RileyMcCarthy/IO_Board/Hardware/Tensile_Board.jpg

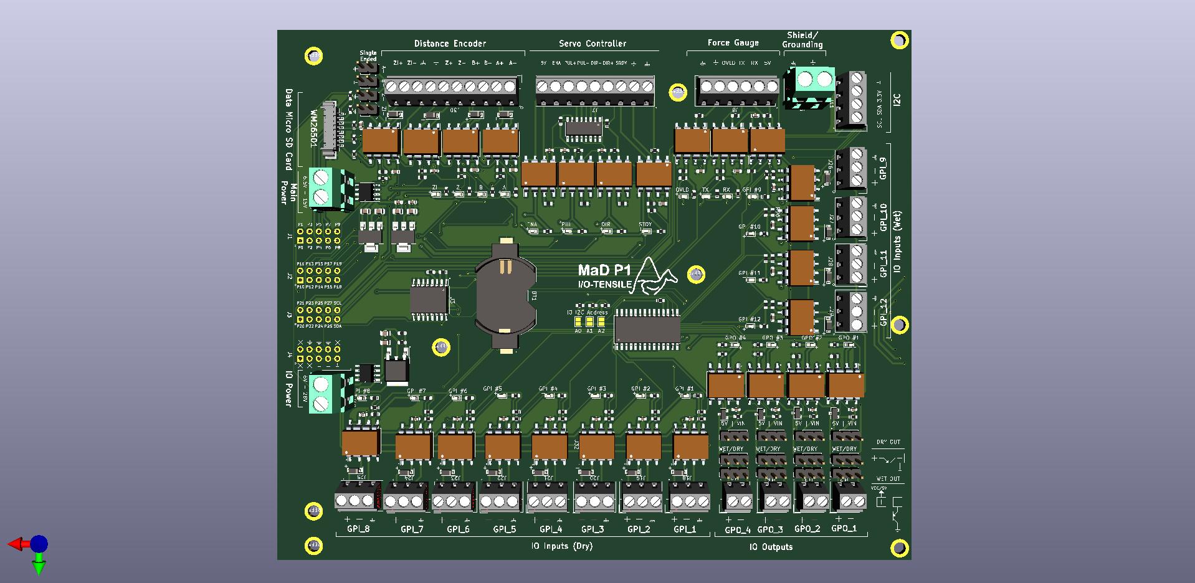
Hardware/Tensile_Board.jpg
