RileyMcCarthy/IO_Board/Docs/3D Views/Tensile_Board_Top.png

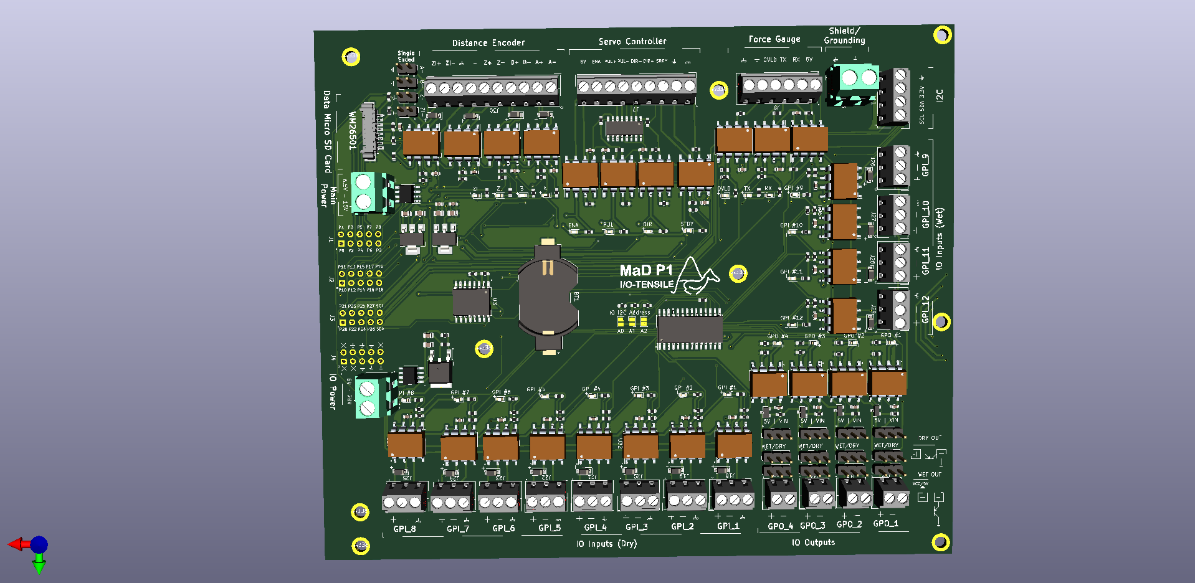
Docs/3D Views/Tensile_Board_Top.png
