RileyMcCarthy/IO_Board/README.md

# IO Board

The IO board is an extension for the Mad Board to maintain an isolated connection to the tensile testing machine.
