RileyMcCarthy/IO_Board/Docs/3D Views/Tensile_Board_Bottom.png

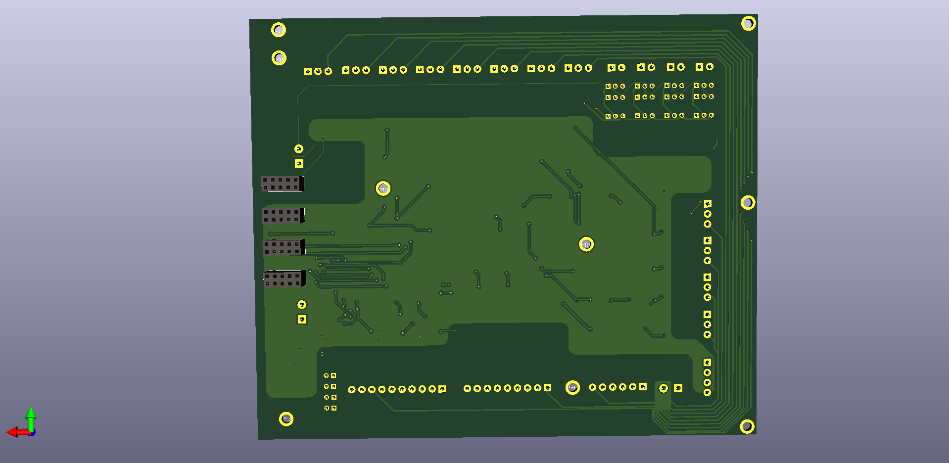
Docs/3D Views/Tensile_Board_Bottom.png
