RileyMcCarthy/IO_Board/Hardware/IO.xlsx

IO | USE | Type | Section | Notes
P0 | SCL2 | OUT | GPIO,RTC
P1 | SCK | OUT | Display Touch
P2 | MOSI | OUT | Display Touch
P3 | MISO | IN | Display Touch
P4 | SD2_DAT3 | IN/OUT | SD Card Data
P5 | SD2_CLK | OUT | SD Card Data
P6 | SD2_CMD | OUT | SD Card Data
P7 | SD2_DAT0 | IN/OUT | SD Card Data | Replaced display touch interrupt
P8 | Backlight | OUT | Display | Backlight replaced with OUTZI
P9 | Reset | OUT | Display
P10 | Chip Select | OUT | Display
P11 | ENA | OUT | Servo Controller
P12 | DIR | OUT | Servo Controller
P13 | PUL | OUT | Servo Controller
P14 | SRDY | IN | Servo Controller
P15 | Force TX | IN | Force Gauge
P16 | Force RX | OUT | Force Gauge
P17 | Overload | IN | Force Gauge
P18 | Status LED | OUT/IN | Charge Pump
P19 | OUTA | IN | Distance A
P20 | OUTB | IN | Distance B
P21 | OUTZ | IN | Distance Z
P22 | SD1_DAT0 | IN/OUT | SD Card Program
P23 | SD1_CLK | OUT | SD Card Program
P24 | SD1_CMD | OUT | SD Card Program
P25 | SD1_DAT3 | IN/OUT | SD Card Program
P26 | SDA2 | OUT/IN | GPIO,RTC
SCL | Peripheral I2C Clock | OUT | Display touch, navkey,eeprom
SDA | Peripheral I2C Data | IN/OUT | Display touch, navkey,eeprom
TX | transmitting | OUT | USB
RX | receiving | IN | USB
