RileyMcCarthy/IO_Board/CAD/Spacer.STEP

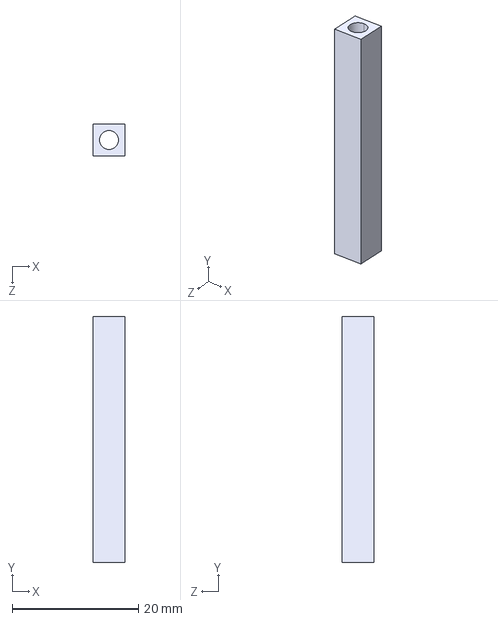
[picture p4: CAD file, 2021-04-02]
CAD/Spacer.STEP
5.00 x 39.0 x 5.00 mm
