RileyMcCarthy/IO_Board/(list of files, cad)

Other CAD files:
CAD/Spacer.SLDPRT
CAD/Spacer.STL
