RileyMcCarthy/IO_Board/Docs/Schematics/Tensile_Board.pdf

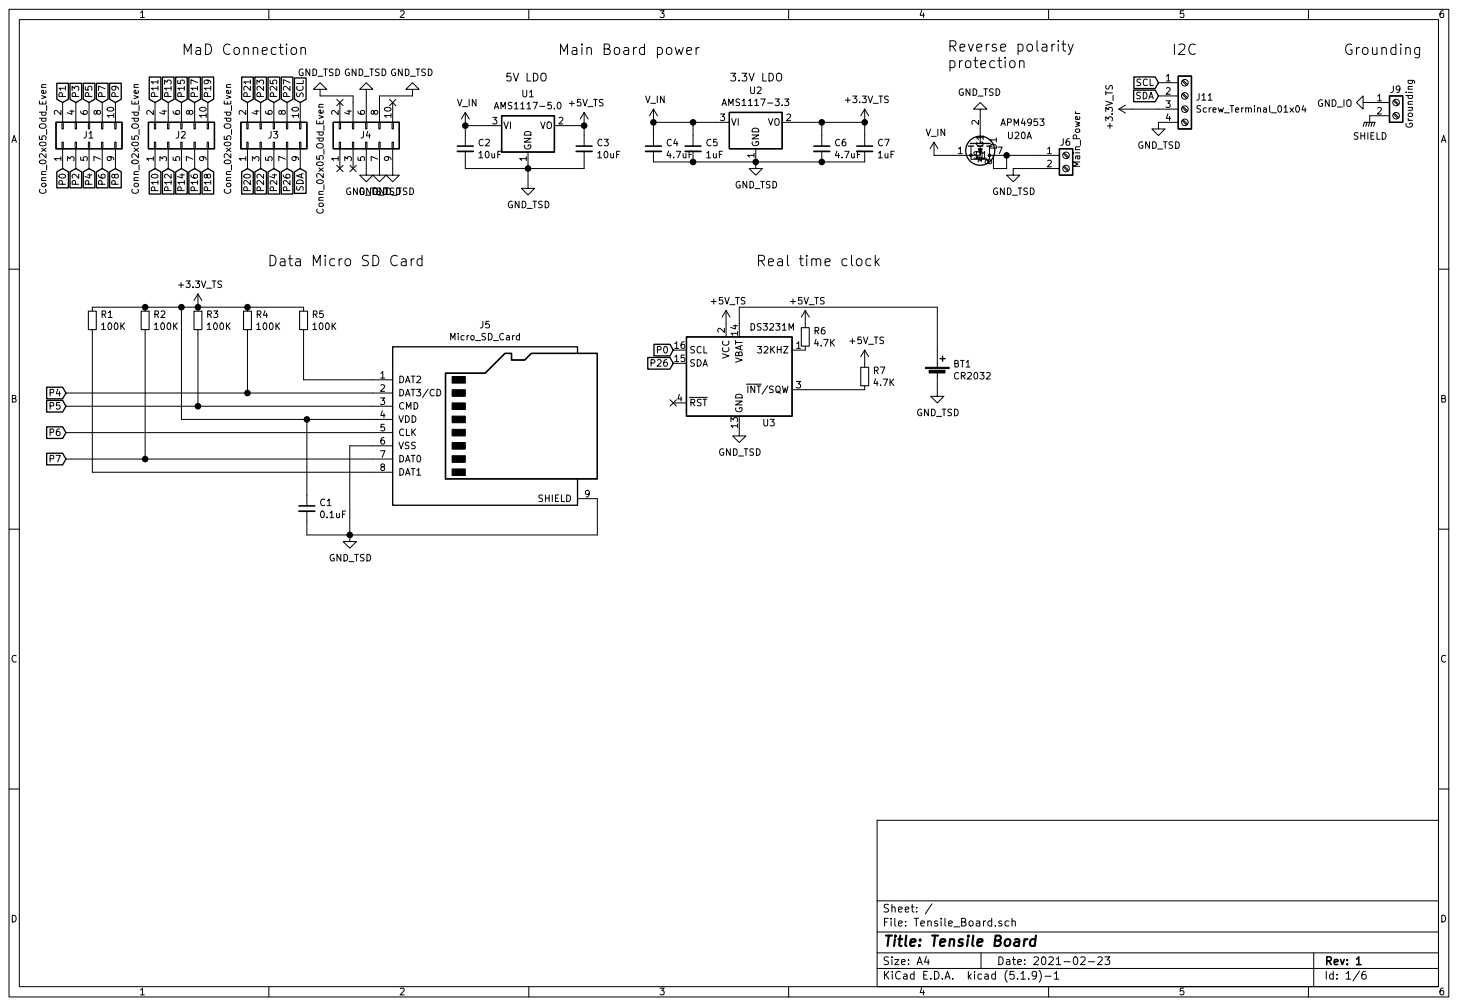
[picture p5: page 1]

File: Tensile_Board.sch Sheet: / Sheet: Force_Gauge

Id: 1/6 Title: Tensile Board

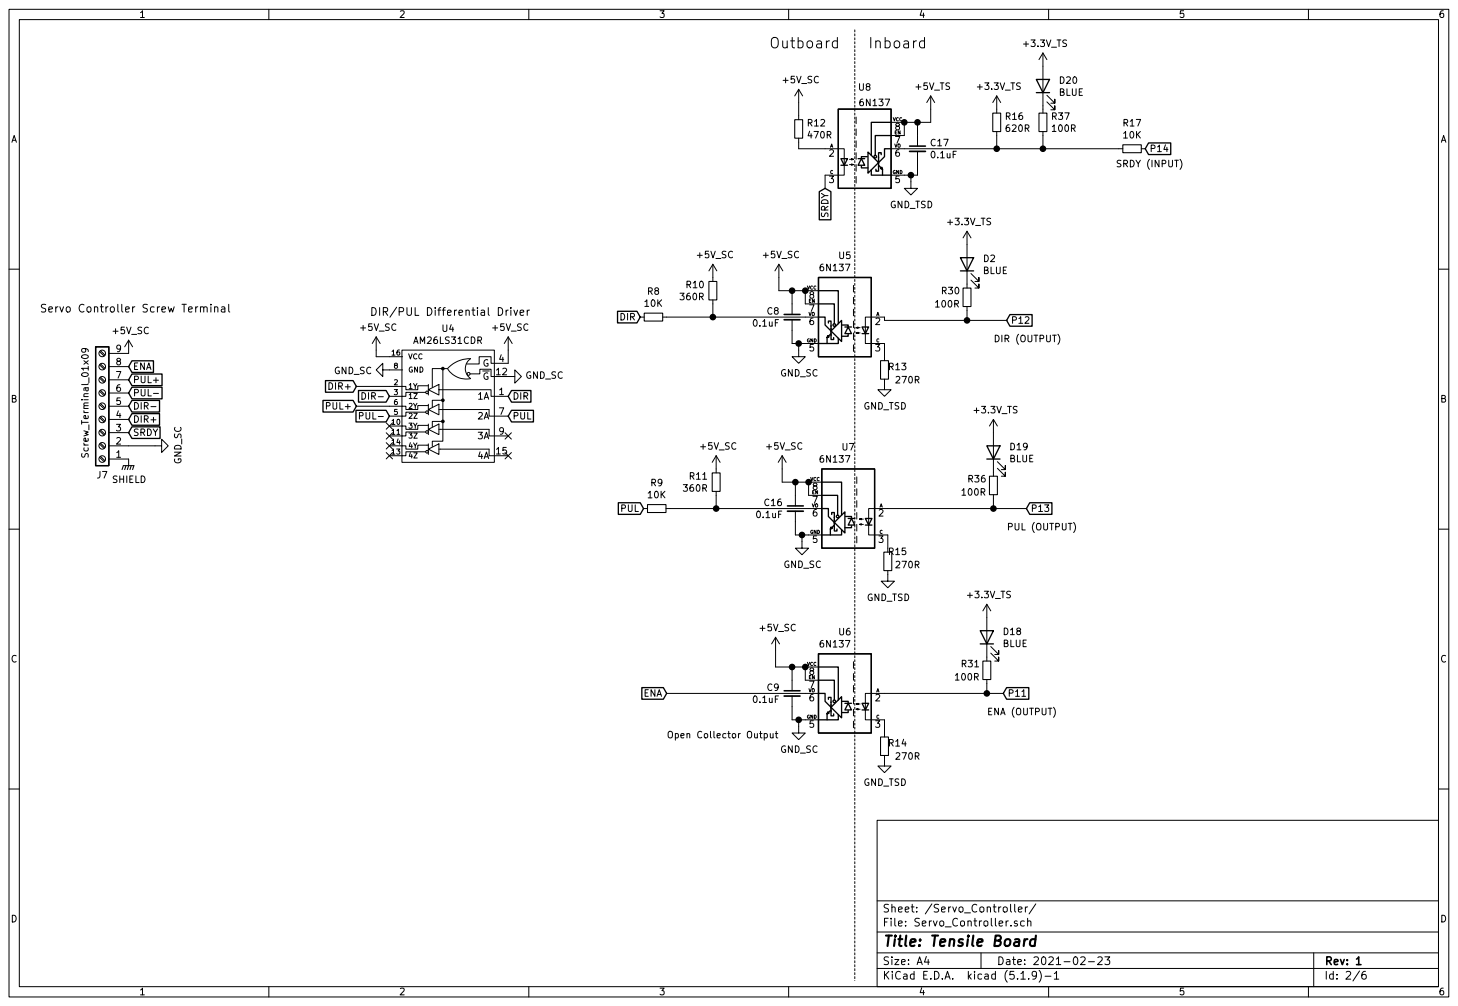
[picture p6: page 2]

Sheet: /Servo_Controller/
File: Servo_Controller.sch
Id: 2/6 Title: Tensile Board

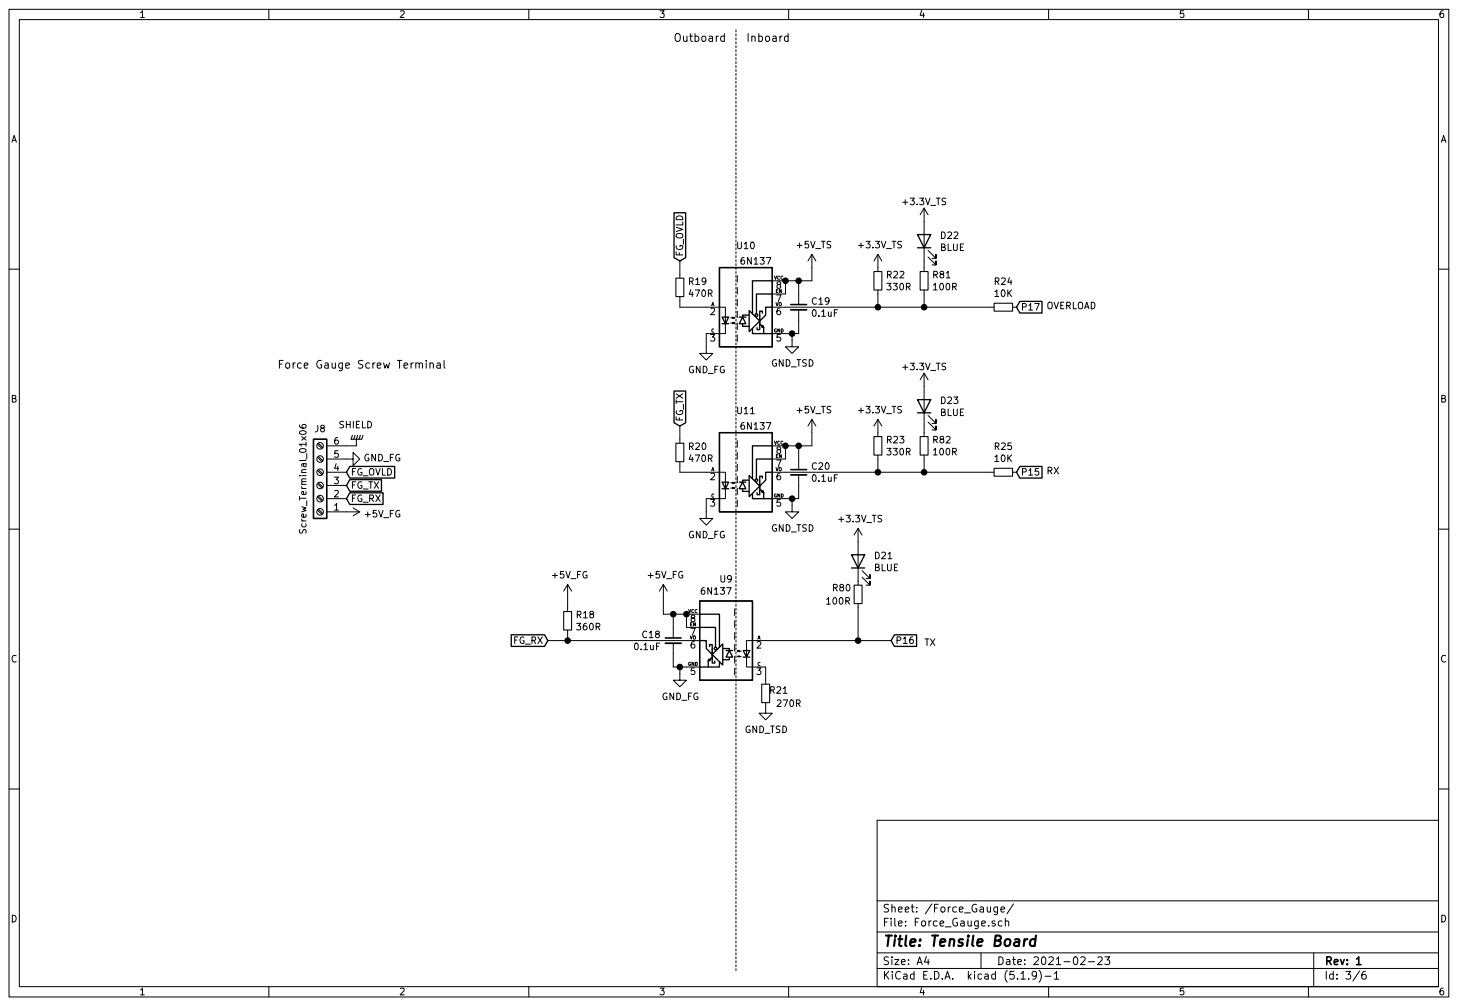
[picture p7: page 3]

File: Force_Gauge.sch
Id: 3/6 Title: Tensile Board

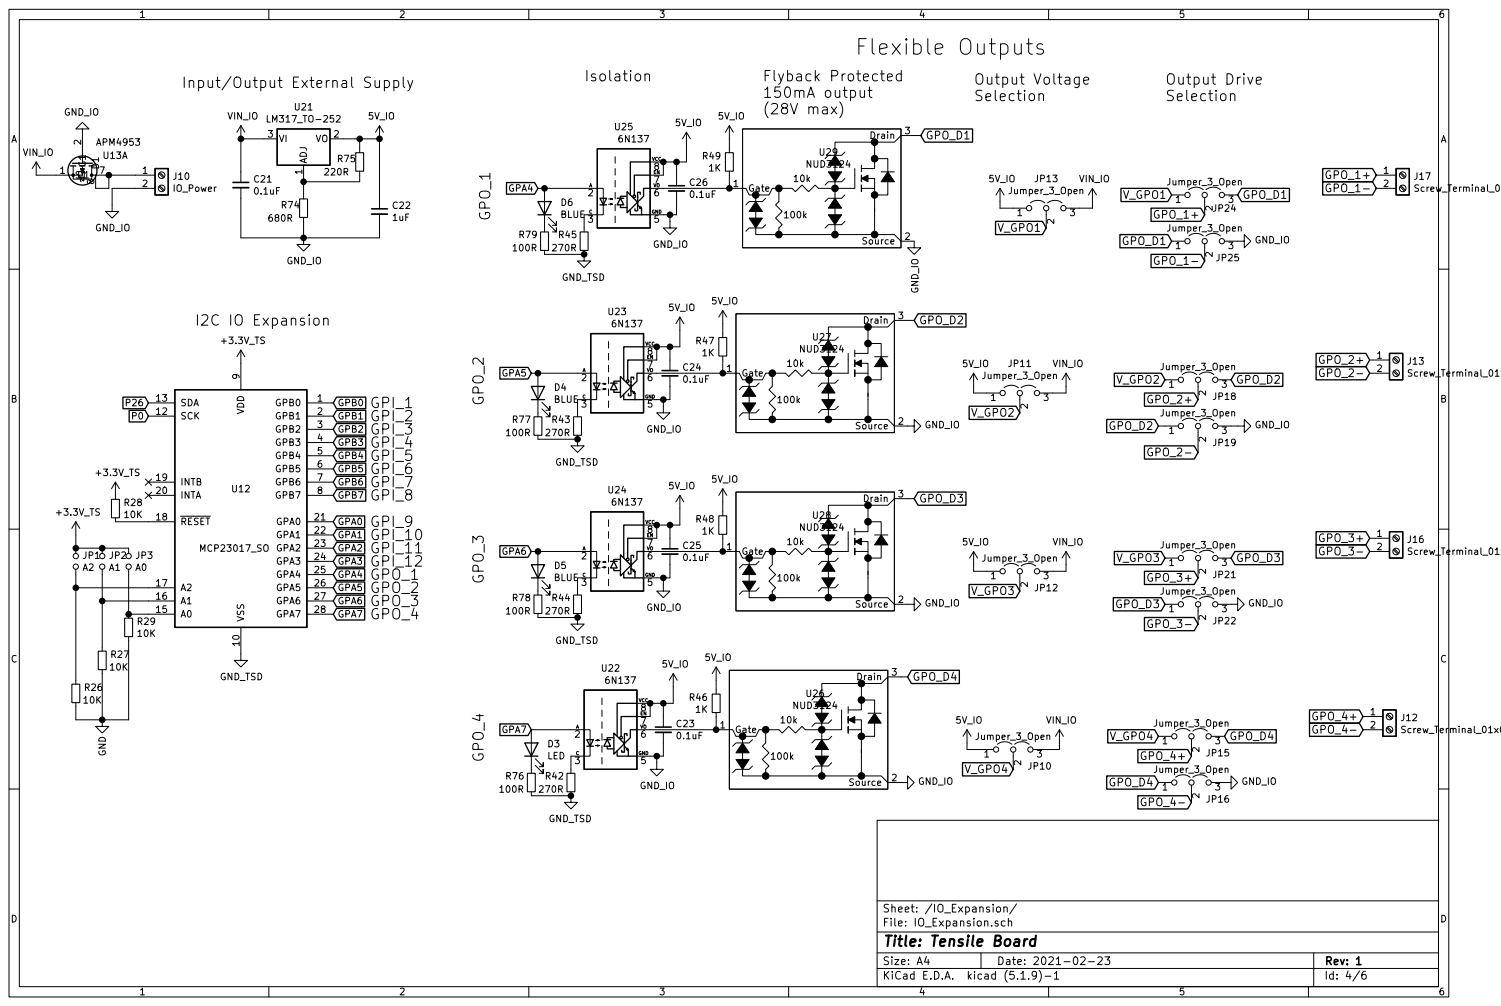
[picture p8: page 4]

Input/Output External Supply

File: IO_Expansion.sch
Id: 4/6 Title: Tensile Board

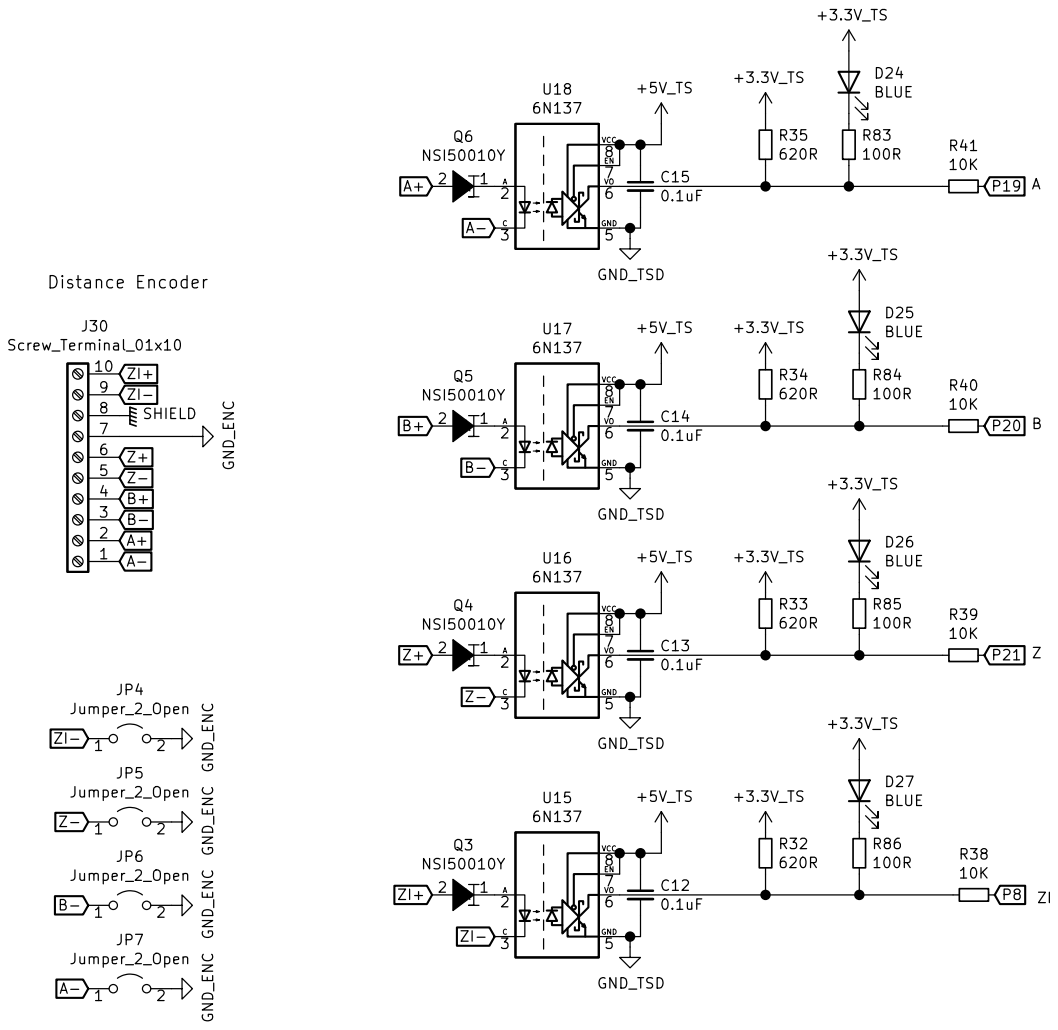
[picture p9: page 5]

that can operate upto 50V. Allowing wide range of input
voltages.
- JP4-JP9 are jumpers used to bypass the line reciever

File: Distance_Gauge.sch
Id: 5/6 Title: Tensile Board

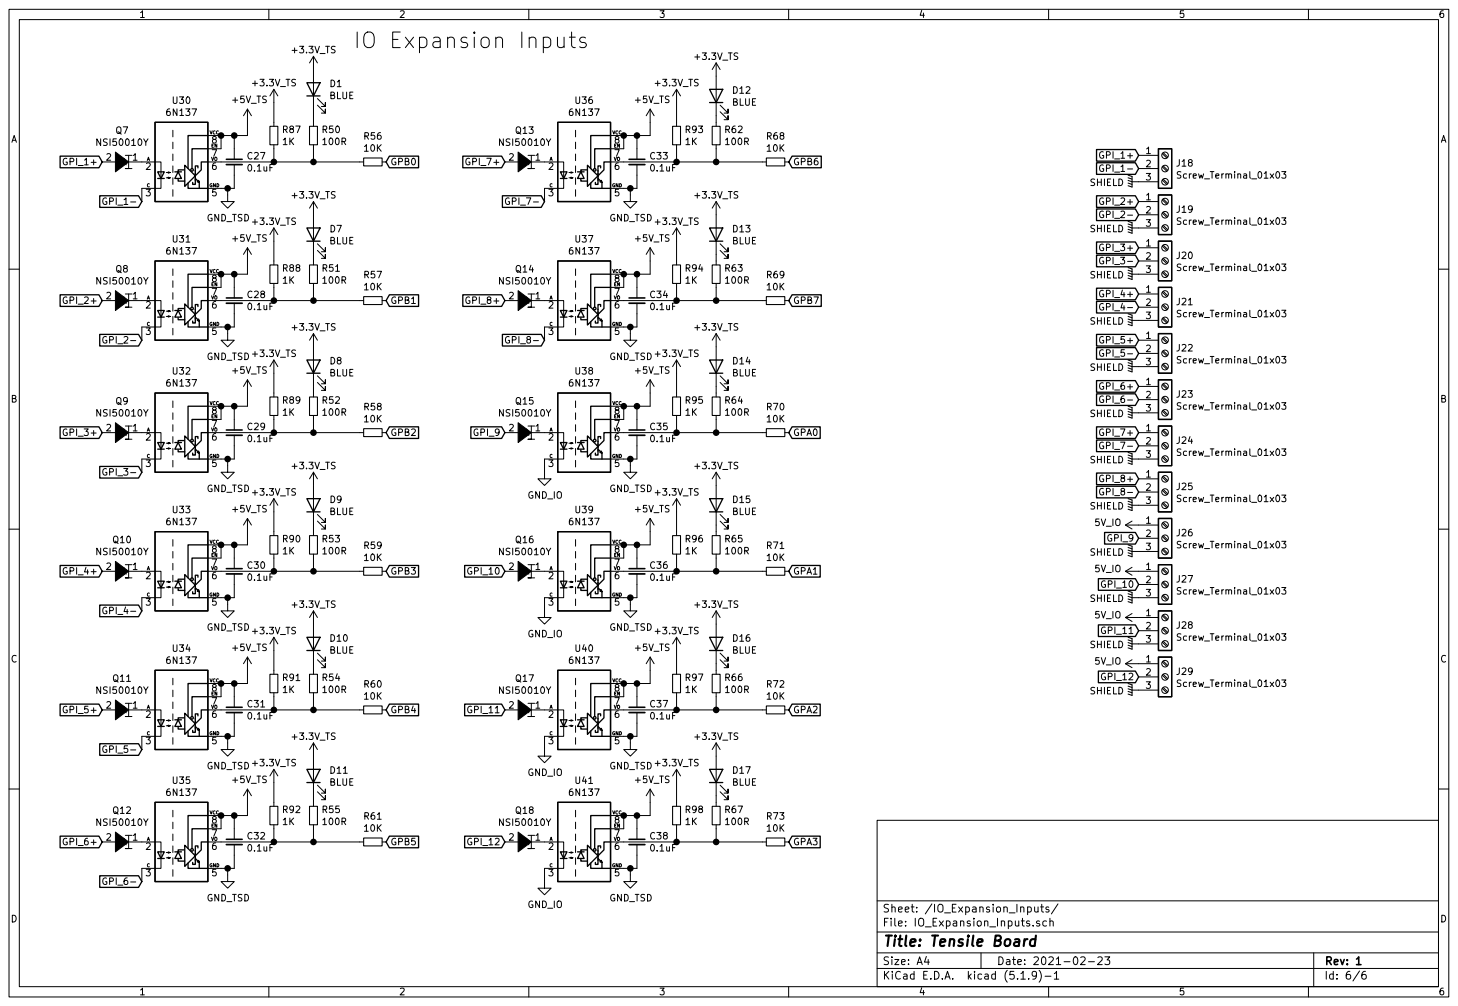
[picture p10: page 6]

Sheet: /IO_Expansion_Inputs/
File: IO_Expansion_Inputs.sch
Id: 6/6 Title: Tensile Board
