RileyMcCarthy/IO_Board/Hardware/Tensile_Board.kicad_pcb

## KiCad design Hardware/Tensile_Board.kicad_pcb (2021-04-02)

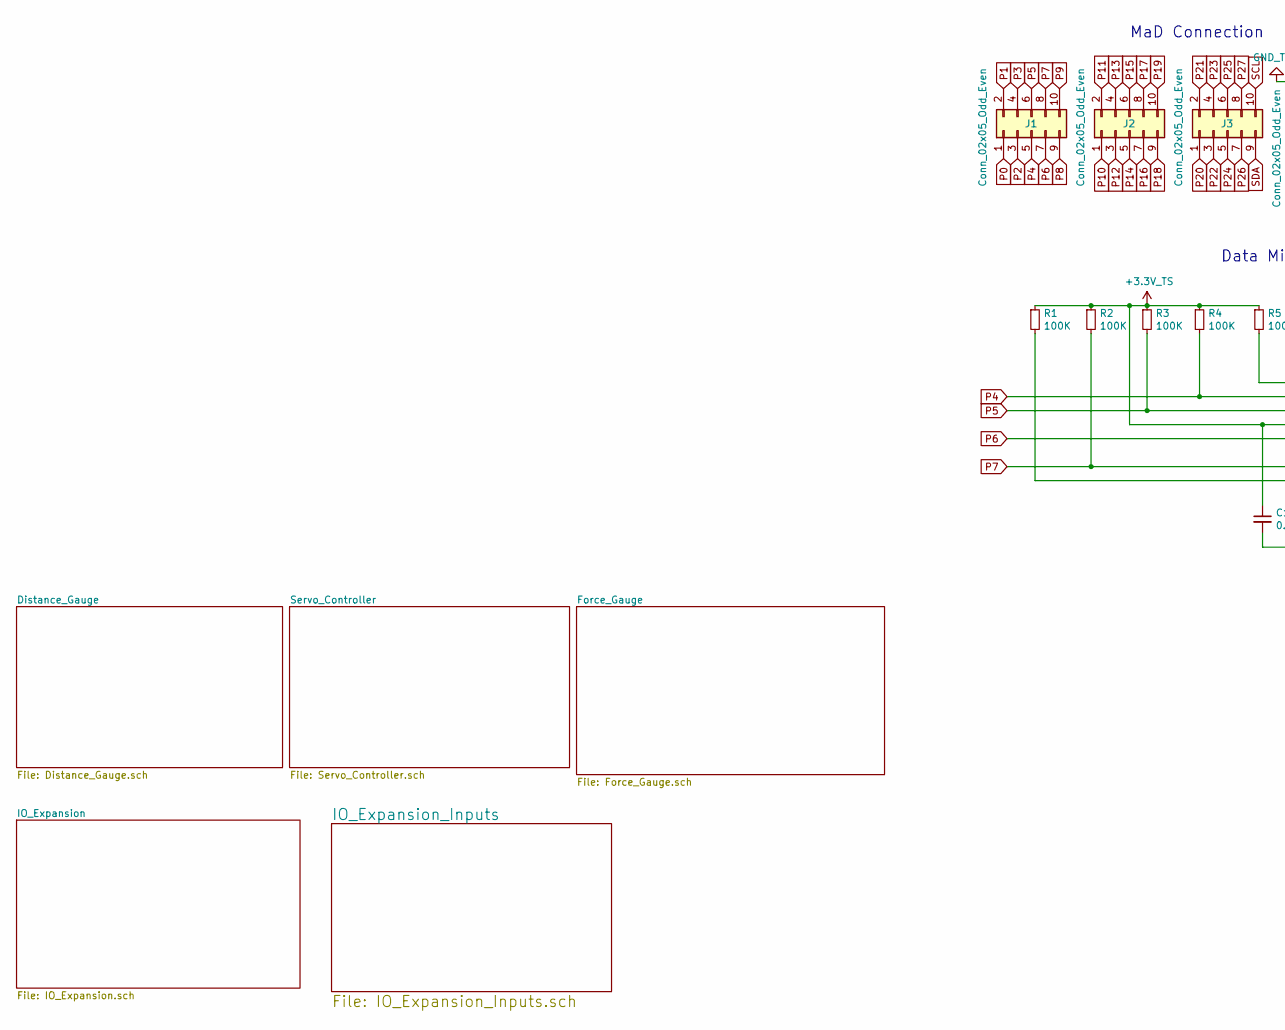
[picture p11: schematic Tensile_Board.sch, Tensile Board, part in row 1, column 1]

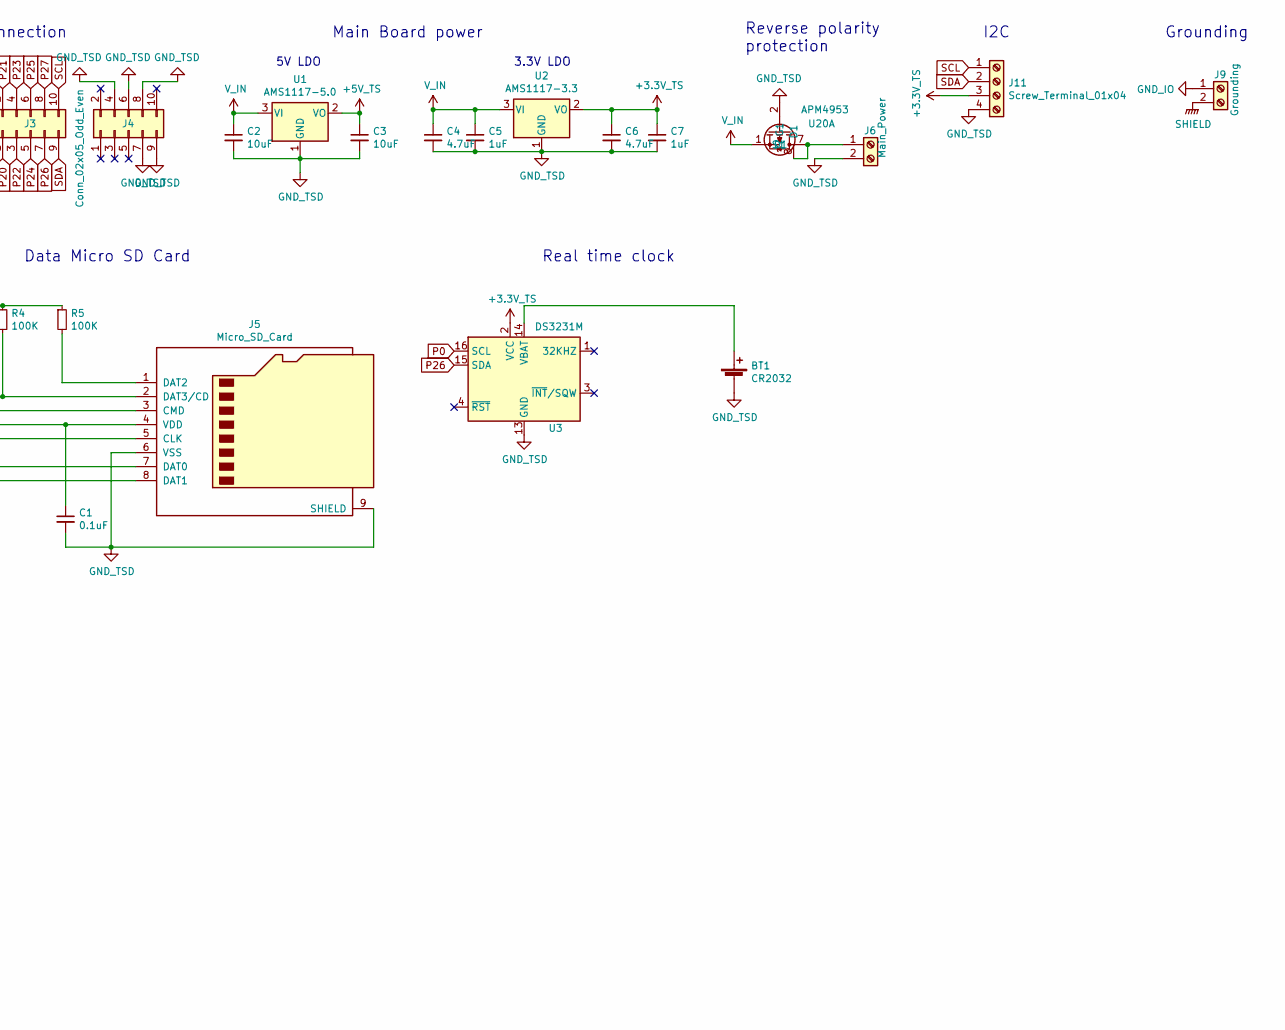
[picture p12: schematic Tensile_Board.sch, Tensile Board, part in row 1, column 2]

Parts:
BT1: CR2032; BatteryHolder_Keystone_1058_1x2032; LCSC C70377
C1: 0.1uF; C_0603_1608Metric; LCSC C14663
C2, C3: 10uF; C_0805_2012Metric; LCSC C15850
C4, C6: 4.7uF; C_0805_2012Metric; LCSC C1779
C5, C7: 1uF; C_0603_1608Metric; LCSC C15849
J1, J2, J3, J4: Conn_02x05_Odd_Even; PinSocket_2x05_P2.54mm_Vertical; LCSC C221045
J5: Micro_SD_Card; WM26501
J6: Main_Power; TerminalBlock_bornier-2_P5.08mm
J9: Grounding; TerminalBlock_bornier-2_P5.08mm
J11: Screw_Terminal_01x04; TerminalBlock_4Ucon_1x04_P3.50mm_Vertical
R1, R2, R3, R4, R5: 100K; R_0603_1608Metric; LCSC C25803
U1: AMS1117-5.0; SOT-223-3_TabPin2; LCSC C6187
U2: AMS1117-3.3; SOT-223-3_TabPin2; LCSC C6186
U3: DS3231M; SOIC-16W_7.5x10.3mm_P1.27mm; LCSC C37663
U20: APM4953; SOP-8_3.9x4.9mm_P1.27mm; LCSC C20897

Connections:
GND_IO: J9.1; also elsewhere on the board
GND_TSD: BT1.2 (-), C1.2, C2.2, C3.2, C4.2, C5.2, C6.2, C7.2, J4.4, J4.5, J4.6, J4.7, J4.8, J4.9, J5.6 (VSS), J5.9 (SHIELD), J6.2, J11.4, U1.1 (GND), U2.1 (GND), U3.5 (GND), U3.6 (GND), U3.7 (GND), U3.8 (GND), U3.9 (GND), U3.10 (GND), U3.11 (GND), U3.12 (GND), U3.13 (GND), U20.2 (G1); also elsewhere on the board
unnamed: BT1.1 (+), U3.14 (VBAT)
unnamed: J5.1 (DAT2), R5.2
unnamed: J5.8 (DAT1), R1.2
unnamed: J6.1, U20.7 (D1), U20.8 (D1)
P1: J1.2
P2: J1.3
P3: J1.4
P4: J1.5, J5.2 (DAT3/CD), R4.2
P5: J1.6, J5.3 (CMD), R3.2
P6: J1.7, J5.5 (CLK)
P7: J1.8, J5.7 (DAT0), R2.2
P8: J1.9; also elsewhere on the board
P9: J1.10
P10: J2.1
P11: J2.2; also elsewhere on the board
P12: J2.3; also elsewhere on the board
P13: J2.4; also elsewhere on the board
P14: J2.5; also elsewhere on the board
P15: J2.6; also elsewhere on the board
P16: J2.7; also elsewhere on the board
P17: J2.8; also elsewhere on the board
P18: J2.9
P19: J2.10; also elsewhere on the board
P20: J3.1; also elsewhere on the board
P21: J3.2; also elsewhere on the board
P22: J3.3
P23: J3.4
P24: J3.5
P25: J3.6
P27: J3.8
SCL: J3.10, J11.1
SDA: J3.9, J11.2
SHIELD: J9.2; also elsewhere on the board
V_IN: C2.1, C4.1, C5.1, U1.3 (VI), U2.3 (VI), U20.1 (S1)

Notes on the sheet:
Grounding
Reverse polarity protection
3.3V LDO
5V LDO
I2C
Data Micro SD Card
Real time clock
Main Board power
MaD Connection

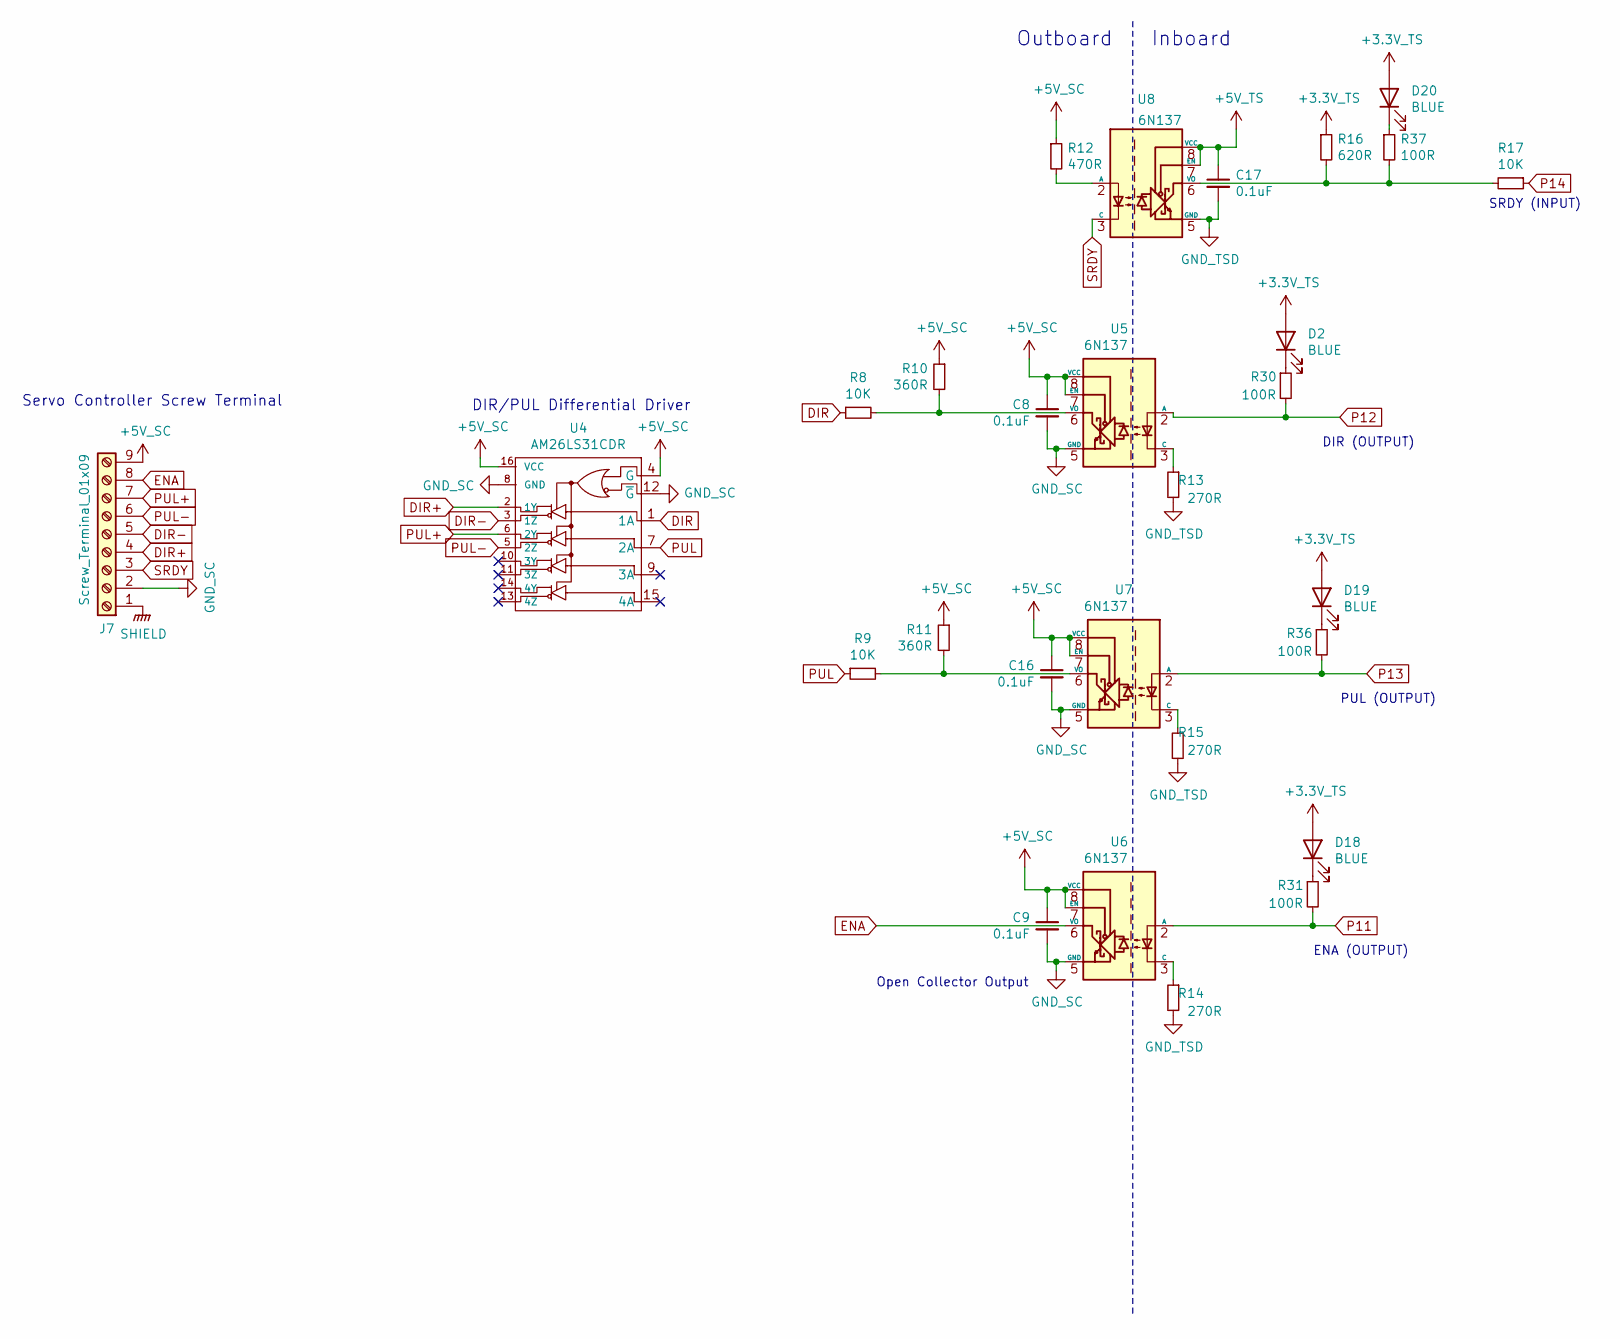
[picture p13: schematic Servo_Controller.sch, Tensile Board]

Parts:
C8, C9, C16, C17: 0.1uF; C_0603_1608Metric; LCSC C14663
D2, D18, D19, D20: BLUE; LED_0603_1608Metric; LCSC C72041
J7: Screw_Terminal_01x09; TerminalBlock_4Ucon_1x09_P3.50mm_Vertical
R8, R9, R17: 10K; R_0603_1608Metric; LCSC C25804
R10, R11: 360R; R_0603_1608Metric; LCSC C25194
R12: 470R; R_0603_1608Metric; LCSC C23179
R13, R14, R15: 270R; R_0603_1608Metric; LCSC C22966
R16: 620R; R_0603_1608Metric; LCSC C23138
R30, R31, R36, R37: 100R; R_0603_1608Metric; LCSC C22775
U4: AM26LS31CDR; SOIC-16_3.9x9.9mm_P1.27mm; LCSC C6179
U5, U6, U7, U8: 6N137; SOP-8_6.62x9.15mm_P2.54mm; LCSC C110020

Connections:
+5V_SC: C8.1, C9.1, C16.1, J7.9, R10.1, R11.1, R12.1, U4.4 (G), U4.16 (VCC), U5.7 (EN), U5.8 (VCC), U6.7 (EN), U6.8 (VCC), U7.7 (EN), U7.8 (VCC)
DIR: R8.1, U4.1 (1A)
DIR+: J7.4, U4.2 (1Y)
DIR-: J7.5, U4.3 (1Z)
ENA: J7.8, U6.6 (VO)
GND_SC: C8.2, C9.2, C16.2, J7.2, U4.8 (GND), U4.12 (~G), U5.5 (GND), U6.5 (GND), U7.5 (GND)
GND_TSD: C17.2, R13.2, R14.2, R15.2, U8.5 (GND); also elsewhere on the board
unnamed: D2.1 (K), R30.1
unnamed: D18.1 (K), R31.1
unnamed: D19.1 (K), R36.1
unnamed: D20.1 (K), R37.1
unnamed: R8.2, R10.2, U5.6 (VO)
unnamed: R9.2, R11.2, U7.6 (VO)
unnamed: R12.2, U8.2 (A)
unnamed: R13.1, U5.3 (C)
unnamed: R14.1, U6.3 (C)
unnamed: R15.1, U7.3 (C)
unnamed: R16.2, R17.2, R37.2, U8.6 (VO)
P11: R31.2, U6.2 (A); also elsewhere on the board
P12: R30.2, U5.2 (A); also elsewhere on the board
P13: R36.2, U7.2 (A); also elsewhere on the board
P14: R17.1; also elsewhere on the board
PUL: R9.1, U4.7 (2A)
PUL+: J7.7, U4.6 (2Y)
PUL-: J7.6, U4.5 (2Z)
SHIELD: J7.1; also elsewhere on the board
SRDY: J7.3, U8.3 (C)

Notes on the sheet:
SRDY (INPUT)
Open Collector Output
DIR (OUTPUT)
PUL (OUTPUT)
ENA (OUTPUT)
Servo Controller Screw Terminal
DIR/PUL Differential Driver
Outboard
Inboard

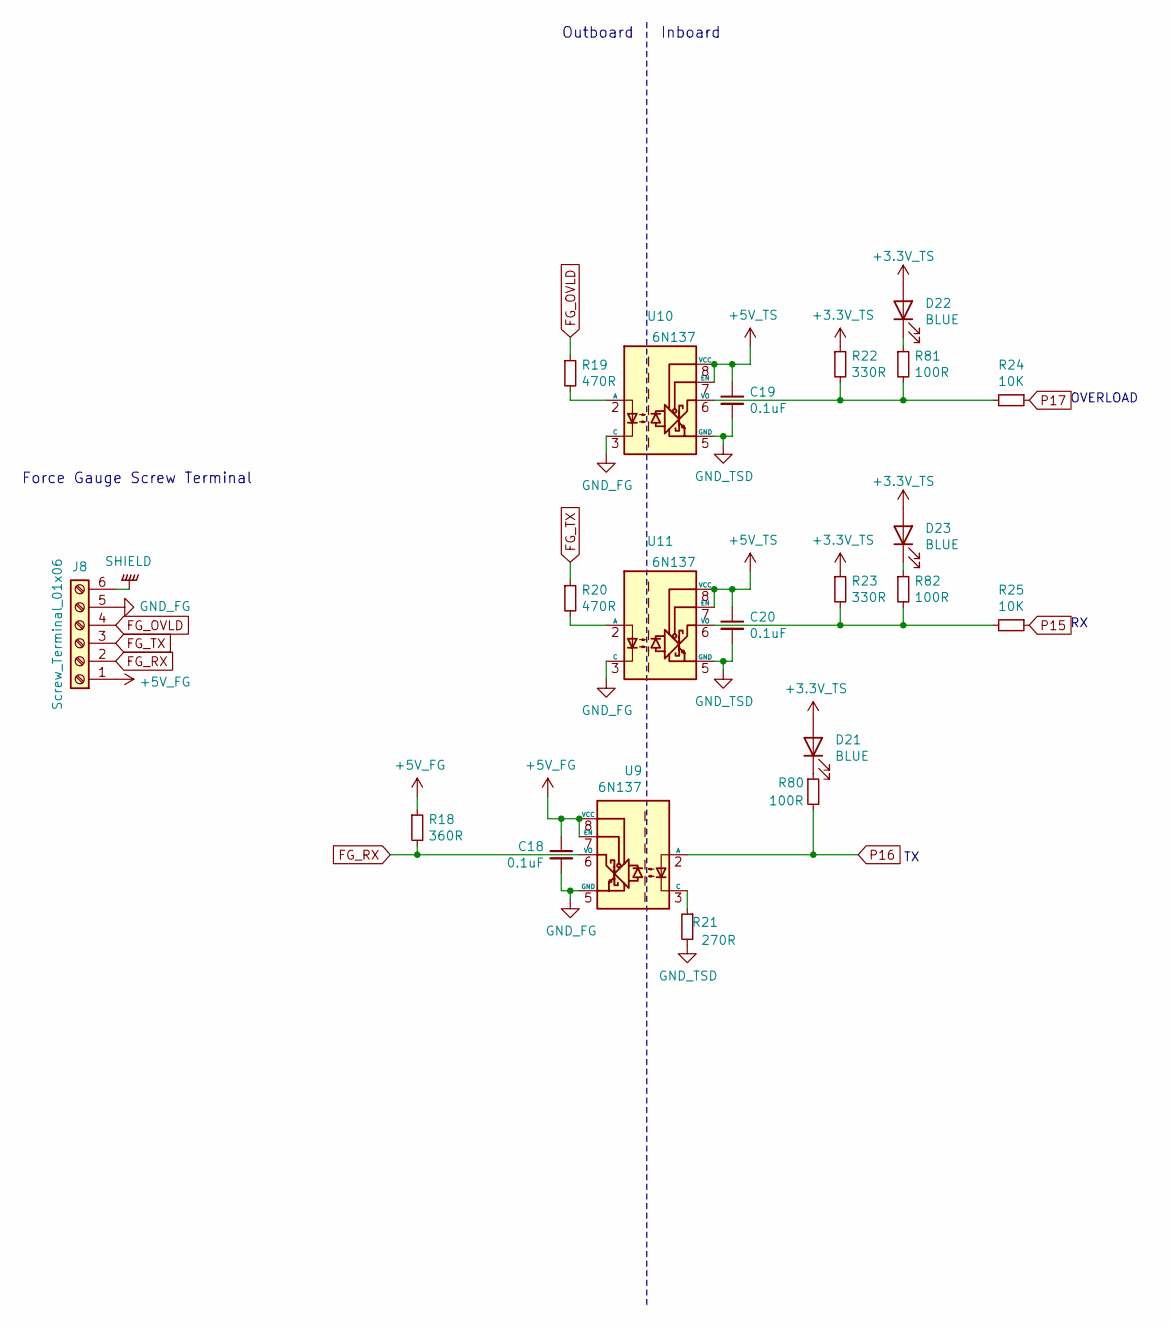
[picture p14: schematic Force_Gauge.sch, Tensile Board]

Parts:
C18, C19, C20: 0.1uF; C_0603_1608Metric; LCSC C14663
D21, D22, D23: BLUE; LED_0603_1608Metric; LCSC C72041
J8: Screw_Terminal_01x06; TerminalBlock_4Ucon_1x06_P3.50mm_Vertical
R18: 360R; R_0603_1608Metric; LCSC C25194
R19, R20: 470R; R_0603_1608Metric; LCSC C23179
R21: 270R; R_0603_1608Metric; LCSC C22966
R22, R23: 330R; R_0603_1608Metric; LCSC C23138
R24, R25: 10K; R_0603_1608Metric; LCSC C25804
R80, R81, R82: 100R; R_0603_1608Metric; LCSC C22775
U9, U10, U11: 6N137; SOP-8_6.62x9.15mm_P2.54mm; LCSC C110020

Connections:
+5V_FG: C18.1, J8.1, R18.1, U9.7 (EN), U9.8 (VCC)
FG_OVLD: J8.4, R19.1
FG_RX: J8.2, R18.2, U9.6 (VO)
FG_TX: J8.3, R20.1
GND_FG: C18.2, J8.5, U9.5 (GND), U10.3 (C), U11.3 (C)
GND_TSD: C19.2, C20.2, R21.2, U10.5 (GND), U11.5 (GND); also elsewhere on the board
unnamed: D21.1 (K), R80.1
unnamed: D22.1 (K), R81.1
unnamed: D23.1 (K), R82.1
unnamed: R19.2, U10.2 (A)
unnamed: R20.2, U11.2 (A)
unnamed: R21.1, U9.3 (C)
unnamed: R22.2, R24.2, R81.2, U10.6 (VO)
unnamed: R23.2, R25.2, R82.2, U11.6 (VO)
P15: R25.1; also elsewhere on the board
P16: R80.2, U9.2 (A); also elsewhere on the board
P17: R24.1; also elsewhere on the board
SHIELD: J8.6; also elsewhere on the board

Notes on the sheet:
OVERLOAD
Outboard
Inboard
Force Gauge Screw Terminal

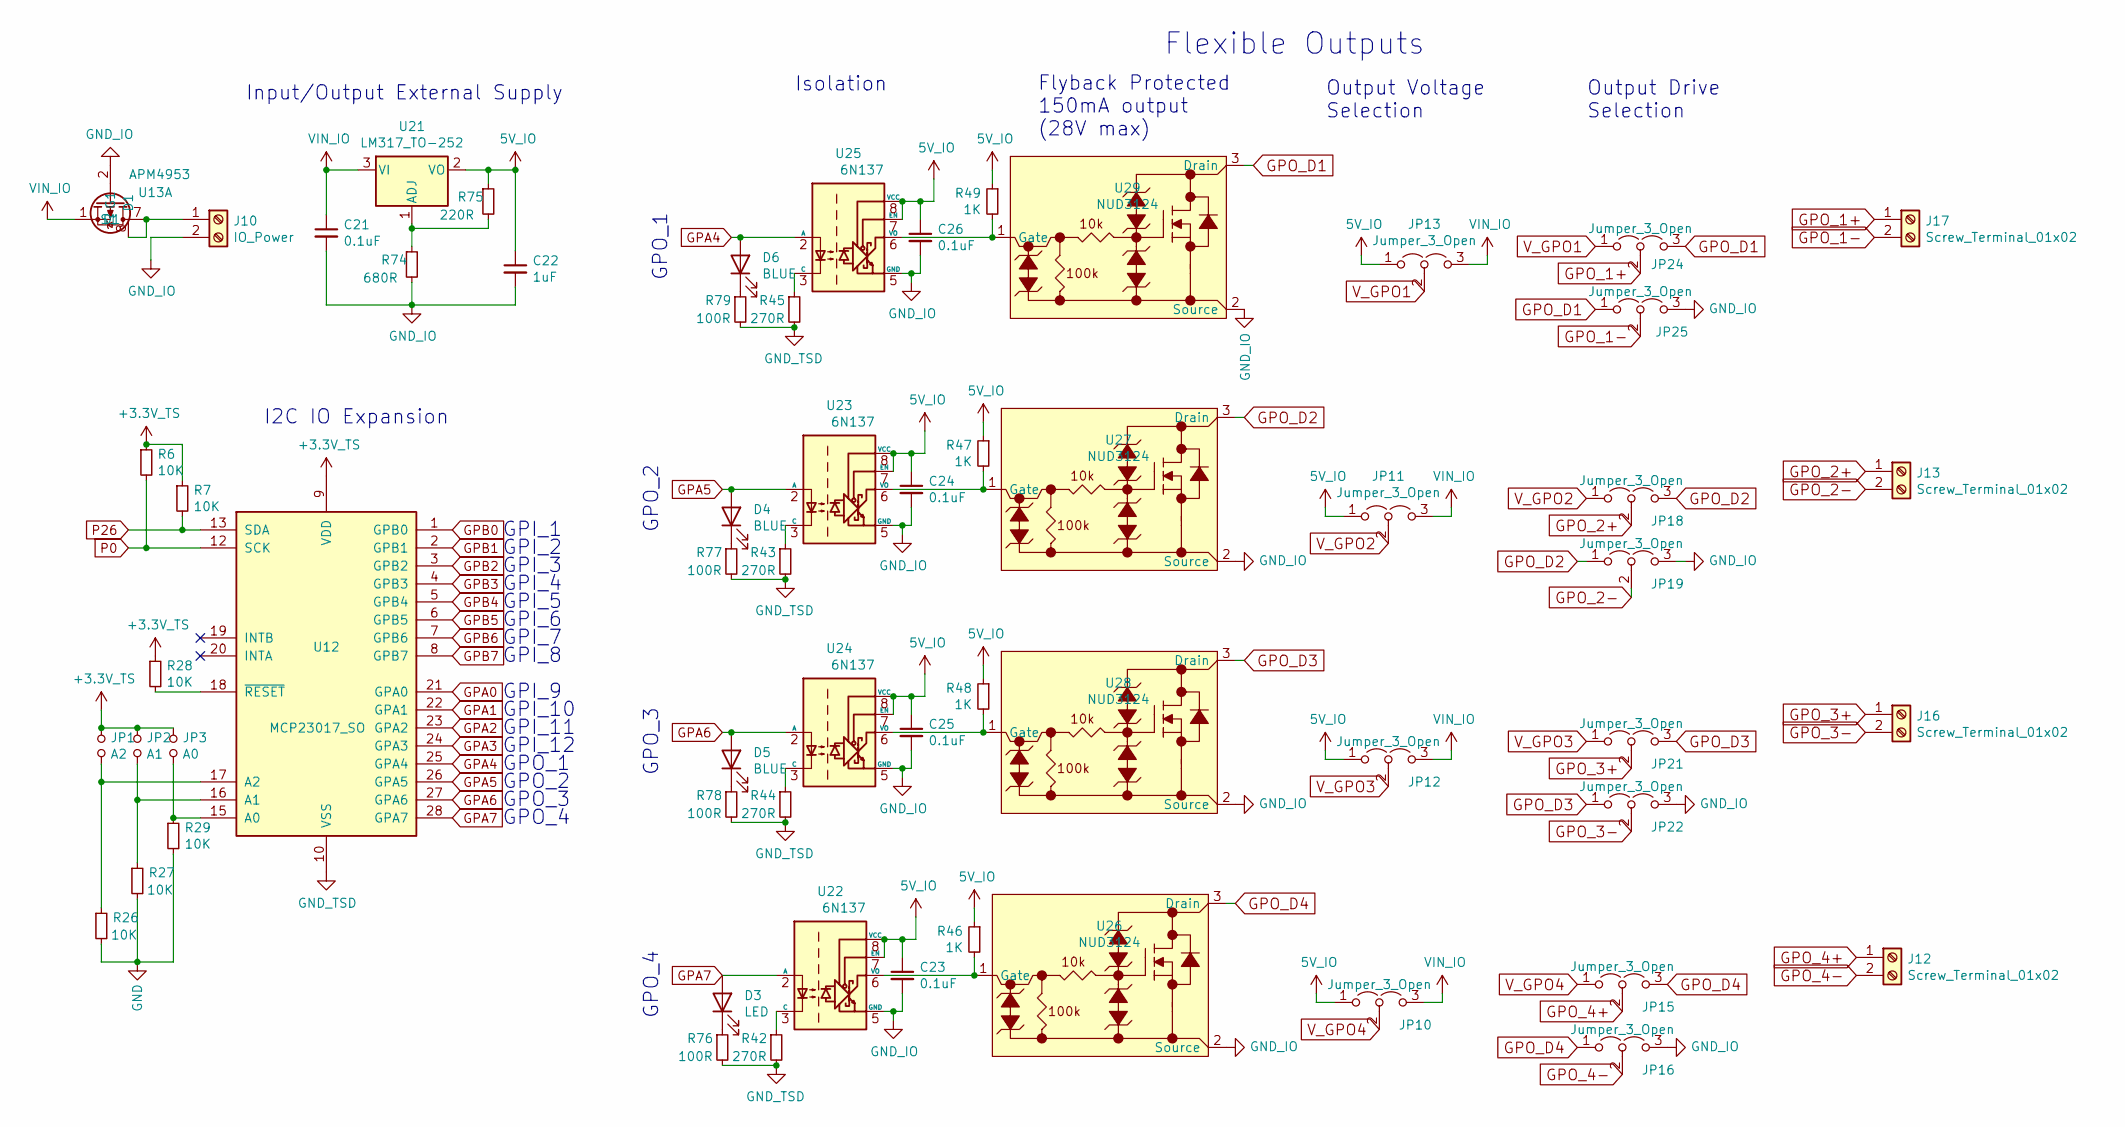
[picture p15: schematic IO_Expansion.sch, Tensile Board]

Parts:
C21: 0.1uF; C_0805_2012Metric; LCSC C49678
C22: 1uF; C_0805_2012Metric; LCSC C28323
C23, C24, C25, C26: 0.1uF; C_0603_1608Metric; LCSC C14663
D3: LED; LED_0603_1608Metric; LCSC C72041
D4, D5, D6: BLUE; LED_0603_1608Metric; LCSC C72041
J10: IO_Power; TerminalBlock_bornier-2_P5.08mm
J12, J13, J16, J17: Screw_Terminal_01x02; TerminalBlock_4Ucon_1x02_P3.50mm_Vertical
JP1: A2; SolderJumper-2_P1.3mm_Open_Pad1.0x1.5mm
JP2: A1; SolderJumper-2_P1.3mm_Open_Pad1.0x1.5mm
JP3: A0; SolderJumper-2_P1.3mm_Open_Pad1.0x1.5mm
JP10, JP11, JP12, JP13, JP15, JP16, JP18, JP19, JP21, JP22, JP24, JP25: Jumper_3_Open; PinHeader_1x03_P2.54mm_Vertical
R6, R7, R26, R27, R28, R29: 10K; R_0603_1608Metric; LCSC C25804
R42, R43, R44, R45: 270R; R_0603_1608Metric; LCSC C22966
R46, R47, R48, R49: 1K; R_0603_1608Metric; LCSC C21190
R74: 680R; R_0603_1608Metric; LCSC C23228
R75: 220R; R_0603_1608Metric; LCSC C22962
R76, R77, R78, R79: 100R; R_0603_1608Metric; LCSC C22775
U12: MCP23017_SO; SOIC-28W_7.5x17.9mm_P1.27mm; LCSC C47023
U13: APM4953; SOP-8_3.9x4.9mm_P1.27mm; LCSC C20897
U21: LM317_TO-252; TO-252-2; LCSC C75510
U22, U23, U24, U25: 6N137; SOP-8_6.62x9.15mm_P2.54mm; LCSC C110020
U26, U27, U28, U29: NUD3124; SOT-23; LCSC C85758

Connections:
5V_IO: C22.1, C23.1, C24.1, C25.1, C26.1, JP10.1 (A), JP11.1 (A), JP12.1 (A), JP13.1 (A), R46.1, R47.1, R48.1, R49.1, R75.1, U21.2 (VO), U22.7 (EN), U22.8 (VCC), U23.7 (EN), U23.8 (VCC), U24.7 (EN), U24.8 (VCC), U25.7 (EN), U25.8 (VCC); also elsewhere on the board
GND: R26.2, R27.2, R29.2
GND_IO: C21.2, C22.2, C23.2, C24.2, C25.2, C26.2, J10.2, JP16.3 (B), JP19.3 (B), JP22.3 (B), JP25.3 (B), R74.2, U13.2 (G1), U22.5 (GND), U23.5 (GND), U24.5 (GND), U25.5 (GND), U26.2 (Source), U27.2 (Source), U28.2 (Source), U29.2 (Source); also elsewhere on the board
GND_TSD: R42.2, R43.2, R44.2, R45.2, R76.2, R77.2, R78.2, R79.2, U12.10 (VSS); also elsewhere on the board
GPA0: U12.21 (GPA0); also elsewhere on the board
GPA1: U12.22 (GPA1); also elsewhere on the board
GPA2: U12.23 (GPA2); also elsewhere on the board
GPA3: U12.24 (GPA3); also elsewhere on the board
GPA4: D6.2 (A), U12.25 (GPA4), U25.2 (A)
GPA5: D4.2 (A), U12.26 (GPA5), U23.2 (A)
GPA6: D5.2 (A), U12.27 (GPA6), U24.2 (A)
GPA7: D3.2 (A), U12.28 (GPA7), U22.2 (A)
GPB0: U12.1 (GPB0); also elsewhere on the board
GPB1: U12.2 (GPB1); also elsewhere on the board
GPB2: U12.3 (GPB2); also elsewhere on the board
GPB3: U12.4 (GPB3); also elsewhere on the board
GPB4: U12.5 (GPB4); also elsewhere on the board
GPB5: U12.6 (GPB5); also elsewhere on the board
GPB6: U12.7 (GPB6); also elsewhere on the board
GPB7: U12.8 (GPB7); also elsewhere on the board
GPO_1+: J17.1, JP24.2 (C)
GPO_1-: J17.2, JP25.2 (C)
GPO_2+: J13.1, JP18.2 (C)
GPO_2-: J13.2, JP19.2 (C)
GPO_3+: J16.1, JP21.2 (C)
GPO_3-: J16.2, JP22.2 (C)
GPO_4+: J12.1, JP15.2 (C)
GPO_4-: J12.2, JP16.2 (C)
GPO_D1: JP24.3 (B), JP25.1 (A), U29.3 (Drain)
GPO_D2: JP18.3 (B), JP19.1 (A), U27.3 (Drain)
GPO_D3: JP21.3 (B), JP22.1 (A), U28.3 (Drain)
GPO_D4: JP15.3 (B), JP16.1 (A), U26.3 (Drain)
unnamed: D3.1 (K), R76.1
unnamed: D4.1 (K), R77.1
unnamed: D5.1 (K), R78.1
unnamed: D6.1 (K), R79.1
unnamed: J10.1, U13.7 (D1), U13.8 (D1)
unnamed: JP1.2, R26.1, U12.17 (A2)
unnamed: JP2.2, R27.1, U12.16 (A1)
unnamed: JP3.2, R29.1, U12.15 (A0)
unnamed: R28.2, U12.18 (~RESET~)
unnamed: R42.1, U22.3 (C)
unnamed: R43.1, U23.3 (C)
unnamed: R44.1, U24.3 (C)
unnamed: R45.1, U25.3 (C)
unnamed: R46.2, U22.6 (VO), U26.1 (Gate)
unnamed: R47.2, U23.6 (VO), U27.1 (Gate)
unnamed: R48.2, U24.6 (VO), U28.1 (Gate)
unnamed: R49.2, U25.6 (VO), U29.1 (Gate)
unnamed: R74.1, R75.2, U21.1 (ADJ)
VIN_IO: C21.1, JP10.3 (B), JP11.3 (B), JP12.3 (B), JP13.3 (B), U13.1 (S1), U21.3 (VI)
V_GPO1: JP13.2 (C), JP24.1 (A)
V_GPO2: JP11.2 (C), JP18.1 (A)
V_GPO3: JP12.2 (C), JP21.1 (A)
V_GPO4: JP10.2 (C), JP15.1 (A)

Notes on the sheet:
I2C IO Expansion
GPI_2
GPI_3
GPI_4
GPI_5
GPI_6
GPI_7
GPI_8
GPI_1
GPO_2
GPO_3
GPO_4
GPO_1
GPI_9
GPI_10
GPI_11
GPI_12
Flexible Outputs
Isolation
Flyback Protected 150mA output (28V max)
Output Voltage Selection
Output Drive Selection
Input/Output External Supply

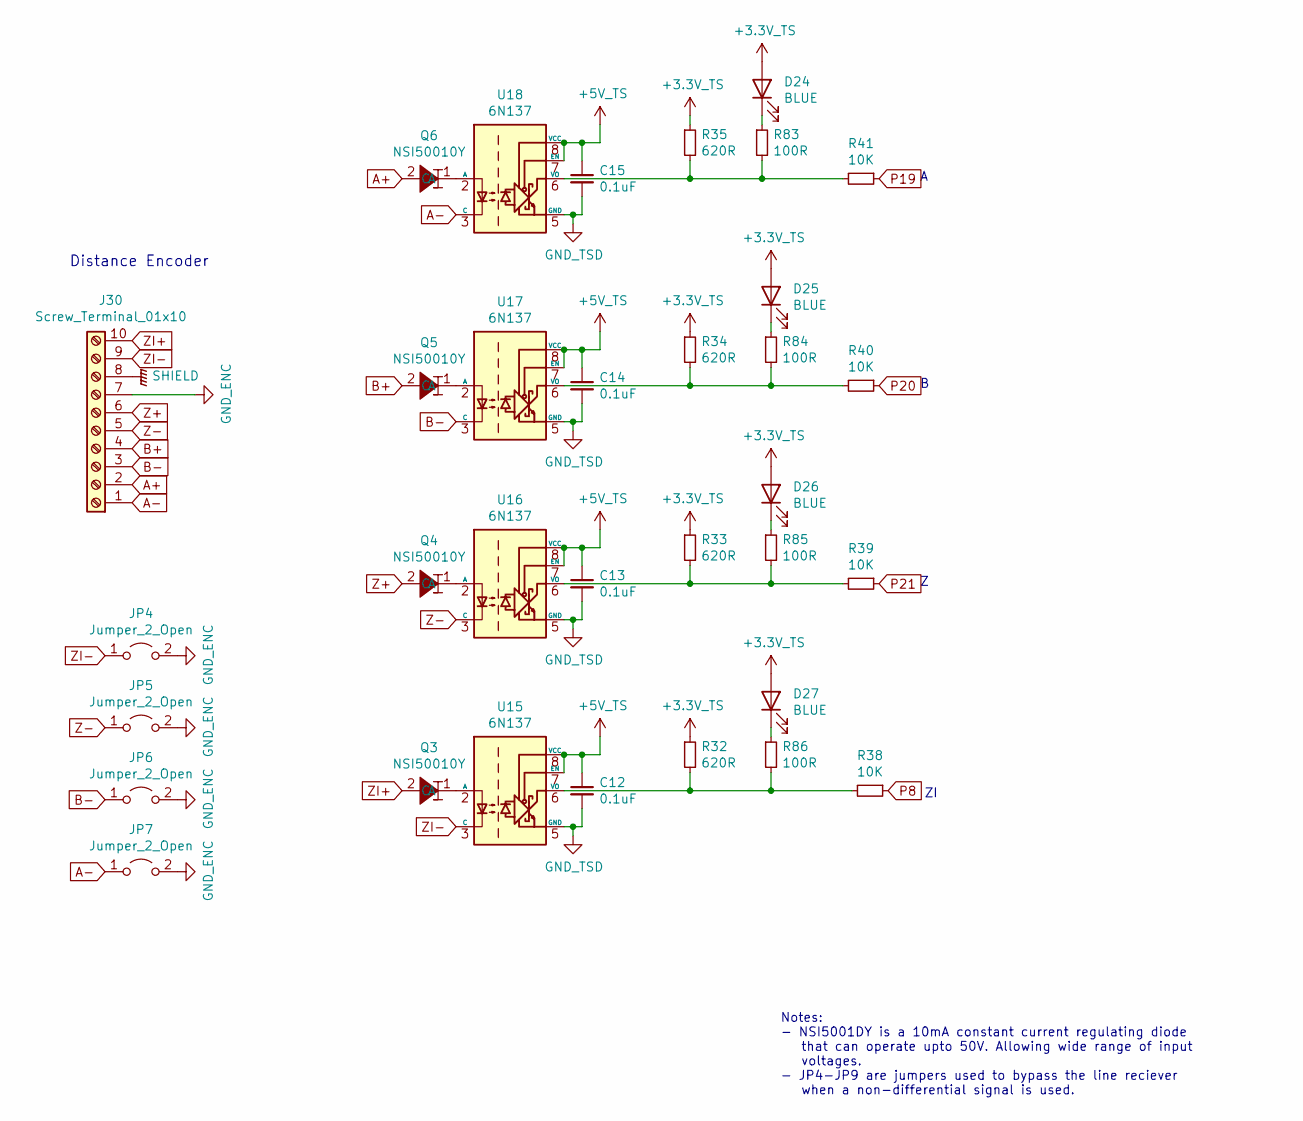
[picture p16: schematic Distance_Gauge.sch, Tensile Board]

Parts:
C12, C13, C14, C15: 0.1uF; C_0603_1608Metric; LCSC C14663
D24, D25, D26, D27: BLUE; LED_0603_1608Metric; LCSC C72041
J30: Screw_Terminal_01x10; TerminalBlock_4Ucon_1x10_P3.50mm_Vertical
JP4, JP5, JP6, JP7: Jumper_2_Open; PinHeader_1x02_P2.54mm_Vertical
Q3, Q4, Q5, Q6: NSI50010Y; D_SOD-123; LCSC C150049
R32, R33, R34, R35: 620R; R_0603_1608Metric; LCSC C23138
R38, R39, R40, R41: 10K; R_0603_1608Metric; LCSC C25804
R83, R84, R85, R86: 100R; R_0603_1608Metric; LCSC C22775
U15, U16, U17, U18: 6N137; SOP-8_6.62x9.15mm_P2.54mm; LCSC C110020

Connections:
GND_ENC: J30.7, JP4.2 (B), JP5.2 (B), JP6.2 (B), JP7.2 (B)
GND_TSD: C12.2, C13.2, C14.2, C15.2, U15.5 (GND), U16.5 (GND), U17.5 (GND), U18.5 (GND); also elsewhere on the board
unnamed: D24.1 (K), R83.1
unnamed: D25.1 (K), R84.1
unnamed: D26.1 (K), R85.1
unnamed: D27.1 (K), R86.1
unnamed: Q3.1 (C), U15.2 (A)
unnamed: Q4.1 (C), U16.2 (A)
unnamed: Q5.1 (C), U17.2 (A)
unnamed: Q6.1 (C), U18.2 (A)
unnamed: R32.2, R38.2, R86.2, U15.6 (VO)
unnamed: R33.2, R39.2, R85.2, U16.6 (VO)
unnamed: R34.2, R40.2, R84.2, U17.6 (VO)
unnamed: R35.2, R41.2, R83.2, U18.6 (VO)
OUTA+: J30.2, Q6.2 (A)
OUTA-: J30.1, JP7.1 (A), U18.3 (C)
OUTB+: J30.4, Q5.2 (A)
OUTB-: J30.3, JP6.1 (A), U17.3 (C)
OUTZ+: J30.6, Q4.2 (A)
OUTZ-: J30.5, JP5.1 (A), U16.3 (C)
OUTZI+: J30.10, Q3.2 (A)
OUTZI-: J30.9, JP4.1 (A), U15.3 (C)
P8: R38.1; also elsewhere on the board
P19: R41.1; also elsewhere on the board
P20: R40.1; also elsewhere on the board
P21: R39.1; also elsewhere on the board
SHIELD: J30.8; also elsewhere on the board

Notes on the sheet:
Notes: - NSI5001DY is a 10mA constant current regulating diode that can operate upto 50V. Allowing wide range of input voltages. - JP4-JP9 are jumpers used to bypass the line reciever when a non-differential signal is used.
Distance Encoder

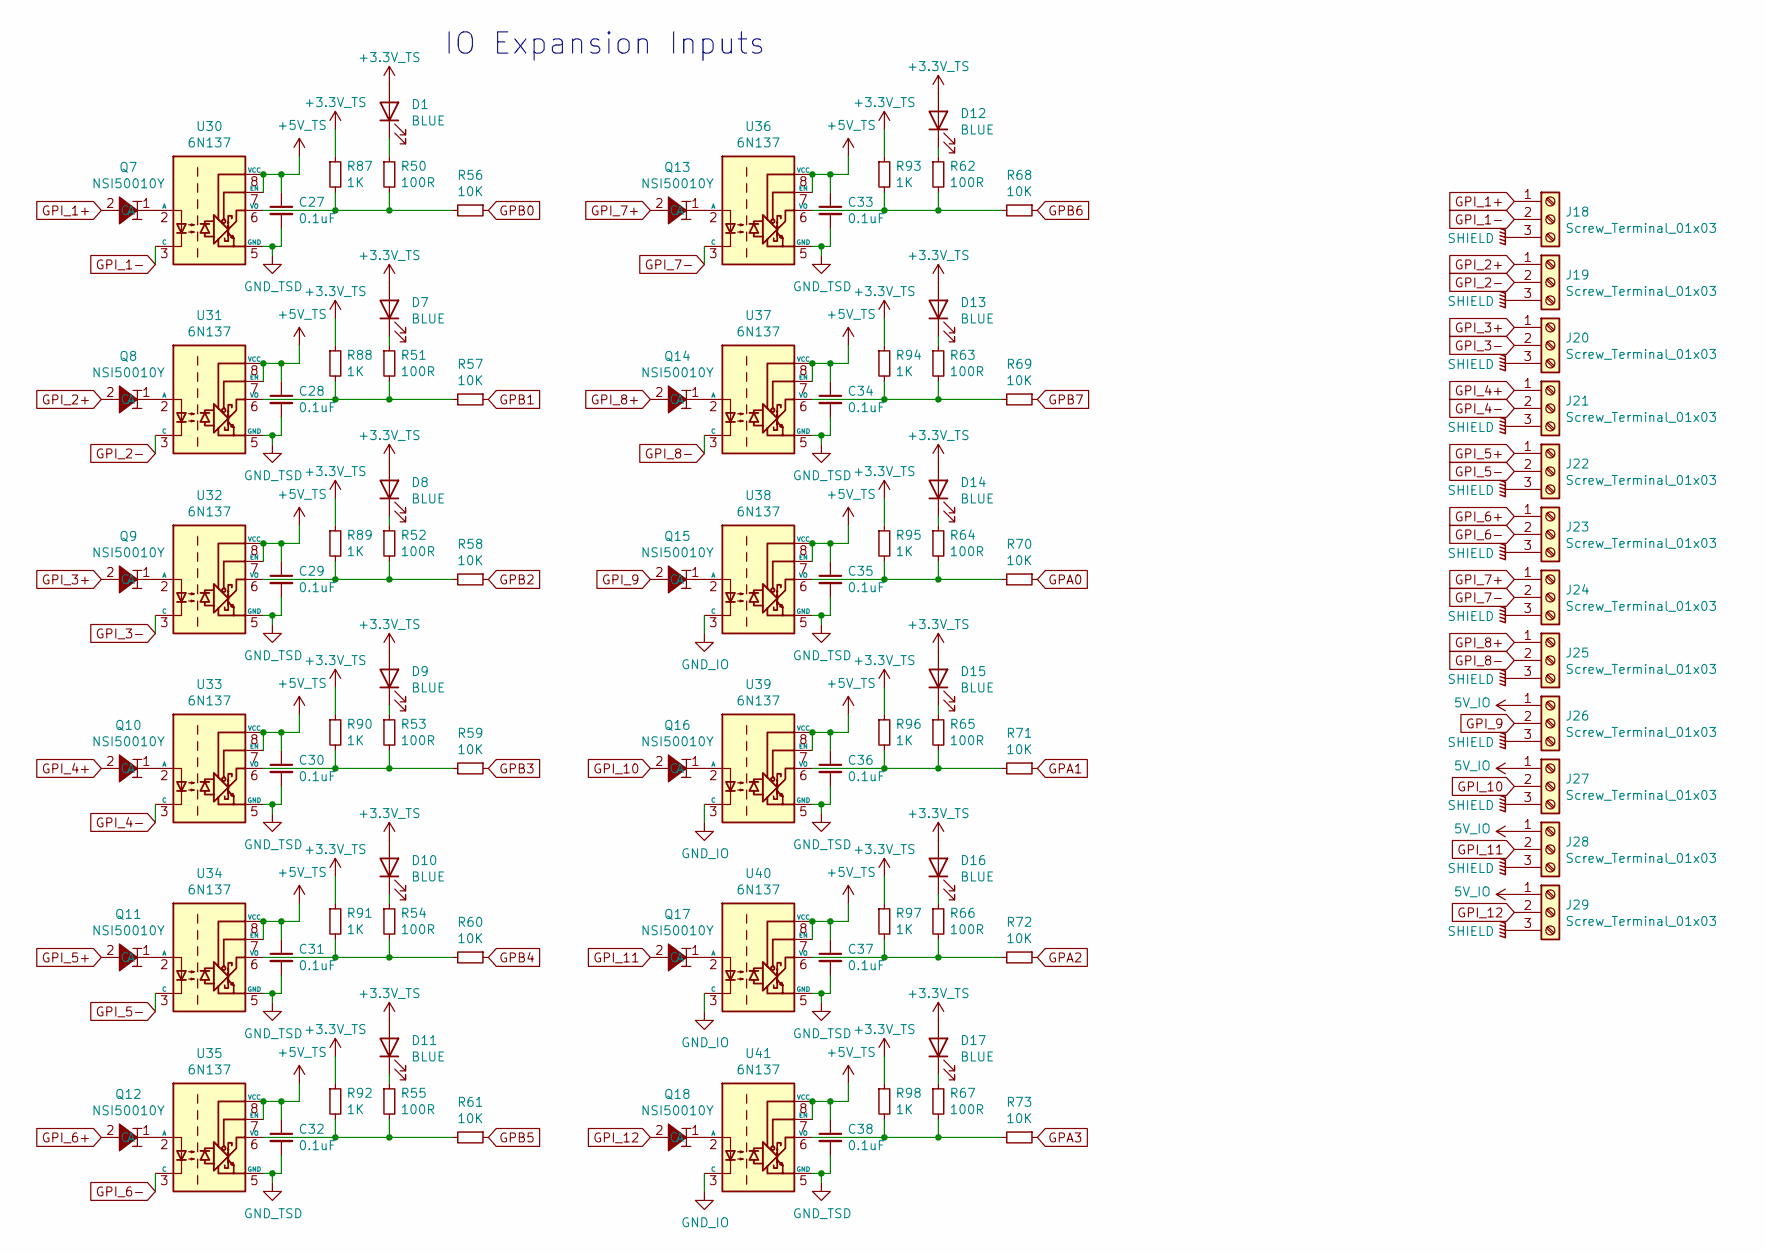
[picture p17: schematic IO_Expansion_Inputs.sch, Tensile Board]

Parts:
C27, C28, C29, C30, C31, C32, C33, C34, C35, C36, C37, C38: 0.1uF; C_0603_1608Metric; LCSC C14663
D1, D7, D8, D9, D10, D11, D12, D13, D14, D15, D16, D17: BLUE; LED_0603_1608Metric; LCSC C72041
J18, J19, J20, J21, J22, J23, J24, J25, J26, J27, J28, J29: Screw_Terminal_01x03; TerminalBlock_4Ucon_1x03_P3.50mm_Vertical
Q7, Q8, Q9, Q10, Q11, Q12, Q13, Q14, Q15, Q16, Q17, Q18: NSI50010Y; D_SOD-123; LCSC C150049
R50, R51, R52, R53, R54, R55, R62, R63, R64, R65, R66, R67: 100R; R_0603_1608Metric; LCSC C22775
R56, R57, R58, R59, R60, R61, R68, R69, R70, R71, R72, R73: 10K; R_0603_1608Metric; LCSC C25804
R87, R88, R89, R90, R91, R92, R93, R94, R95, R96, R97, R98: 1K; R_0603_1608Metric; LCSC C21190
U30, U31, U32, U33, U34, U35, U36, U37, U38, U39, U40, U41: 6N137; SOP-8_6.62x9.15mm_P2.54mm; LCSC C110020

Connections:
5V_IO: J26.1, J27.1, J28.1, J29.1; also elsewhere on the board
GND_IO: U38.3 (C), U39.3 (C), U40.3 (C), U41.3 (C); also elsewhere on the board
GND_TSD: C27.2, C28.2, C29.2, C30.2, C31.2, C32.2, C33.2, C34.2, C35.2, C36.2, C37.2, C38.2, U30.5 (GND), U31.5 (GND), U32.5 (GND), U33.5 (GND), U34.5 (GND), U35.5 (GND), U36.5 (GND), U37.5 (GND), U38.5 (GND), U39.5 (GND), U40.5 (GND), U41.5 (GND); also elsewhere on the board
GPA0: R70.1; also elsewhere on the board
GPA1: R71.1; also elsewhere on the board
GPA2: R72.1; also elsewhere on the board
GPA3: R73.1; also elsewhere on the board
GPB0: R56.1; also elsewhere on the board
GPB1: R57.1; also elsewhere on the board
GPB2: R58.1; also elsewhere on the board
GPB3: R59.1; also elsewhere on the board
GPB4: R60.1; also elsewhere on the board
GPB5: R61.1; also elsewhere on the board
GPB6: R68.1; also elsewhere on the board
GPB7: R69.1; also elsewhere on the board
GPI_1+: J18.1, Q7.2 (A)
GPI_1-: J18.2, U30.3 (C)
GPI_2+: J19.1, Q8.2 (A)
GPI_2-: J19.2, U31.3 (C)
GPI_3+: J20.1, Q9.2 (A)
GPI_3-: J20.2, U32.3 (C)
GPI_4+: J21.1, Q10.2 (A)
GPI_4-: J21.2, U33.3 (C)
GPI_5+: J22.1, Q11.2 (A)
GPI_5-: J22.2, U34.3 (C)
GPI_6+: J23.1, Q12.2 (A)
GPI_6-: J23.2, U35.3 (C)
GPI_7+: J24.1, Q13.2 (A)
GPI_7-: J24.2, U36.3 (C)
GPI_8+: J25.1, Q14.2 (A)
GPI_8-: J25.2, U37.3 (C)
GPI_9: J26.2, Q15.2 (A)
GPI_10: J27.2, Q16.2 (A)
GPI_11: J28.2, Q17.2 (A)
GPI_12: J29.2, Q18.2 (A)
unnamed: D1.1 (K), R50.1
unnamed: D7.1 (K), R51.1
unnamed: D8.1 (K), R52.1
unnamed: D9.1 (K), R53.1
unnamed: D10.1 (K), R54.1
unnamed: D11.1 (K), R55.1
unnamed: D12.1 (K), R62.1
unnamed: D13.1 (K), R63.1
unnamed: D14.1 (K), R64.1
unnamed: D15.1 (K), R65.1
unnamed: D16.1 (K), R66.1
unnamed: D17.1 (K), R67.1
unnamed: Q7.1 (C), U30.2 (A)
unnamed: Q8.1 (C), U31.2 (A)
unnamed: Q9.1 (C), U32.2 (A)
unnamed: Q10.1 (C), U33.2 (A)
unnamed: Q11.1 (C), U34.2 (A)
unnamed: Q12.1 (C), U35.2 (A)
unnamed: Q13.1 (C), U36.2 (A)
unnamed: Q14.1 (C), U37.2 (A)
unnamed: Q15.1 (C), U38.2 (A)
unnamed: Q16.1 (C), U39.2 (A)
unnamed: Q17.1 (C), U40.2 (A)
unnamed: Q18.1 (C), U41.2 (A)
unnamed: R50.2, R56.2, R87.2, U30.6 (VO)
unnamed: R51.2, R57.2, R88.2, U31.6 (VO)
unnamed: R52.2, R58.2, R89.2, U32.6 (VO)
unnamed: R53.2, R59.2, R90.2, U33.6 (VO)
unnamed: R54.2, R60.2, R91.2, U34.6 (VO)
unnamed: R55.2, R61.2, R92.2, U35.6 (VO)
unnamed: R62.2, R68.2, R93.2, U36.6 (VO)
unnamed: R63.2, R69.2, R94.2, U37.6 (VO)
unnamed: R64.2, R70.2, R95.2, U38.6 (VO)
unnamed: R65.2, R71.2, R96.2, U39.6 (VO)
unnamed: R66.2, R72.2, R97.2, U40.6 (VO)
unnamed: R67.2, R73.2, R98.2, U41.6 (VO)
SHIELD: J18.3, J19.3, J20.3, J21.3, J22.3, J23.3, J24.3, J25.3, J26.3, J27.3, J28.3, J29.3; also elsewhere on the board

Notes on the sheet:
IO Expansion Inputs

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
