RileyMcCarthy/IO_Board/Hardware/Tensile_Board.kicad_pcb

## KiCad design Hardware/Tensile_Board.kicad_pcb (continued)

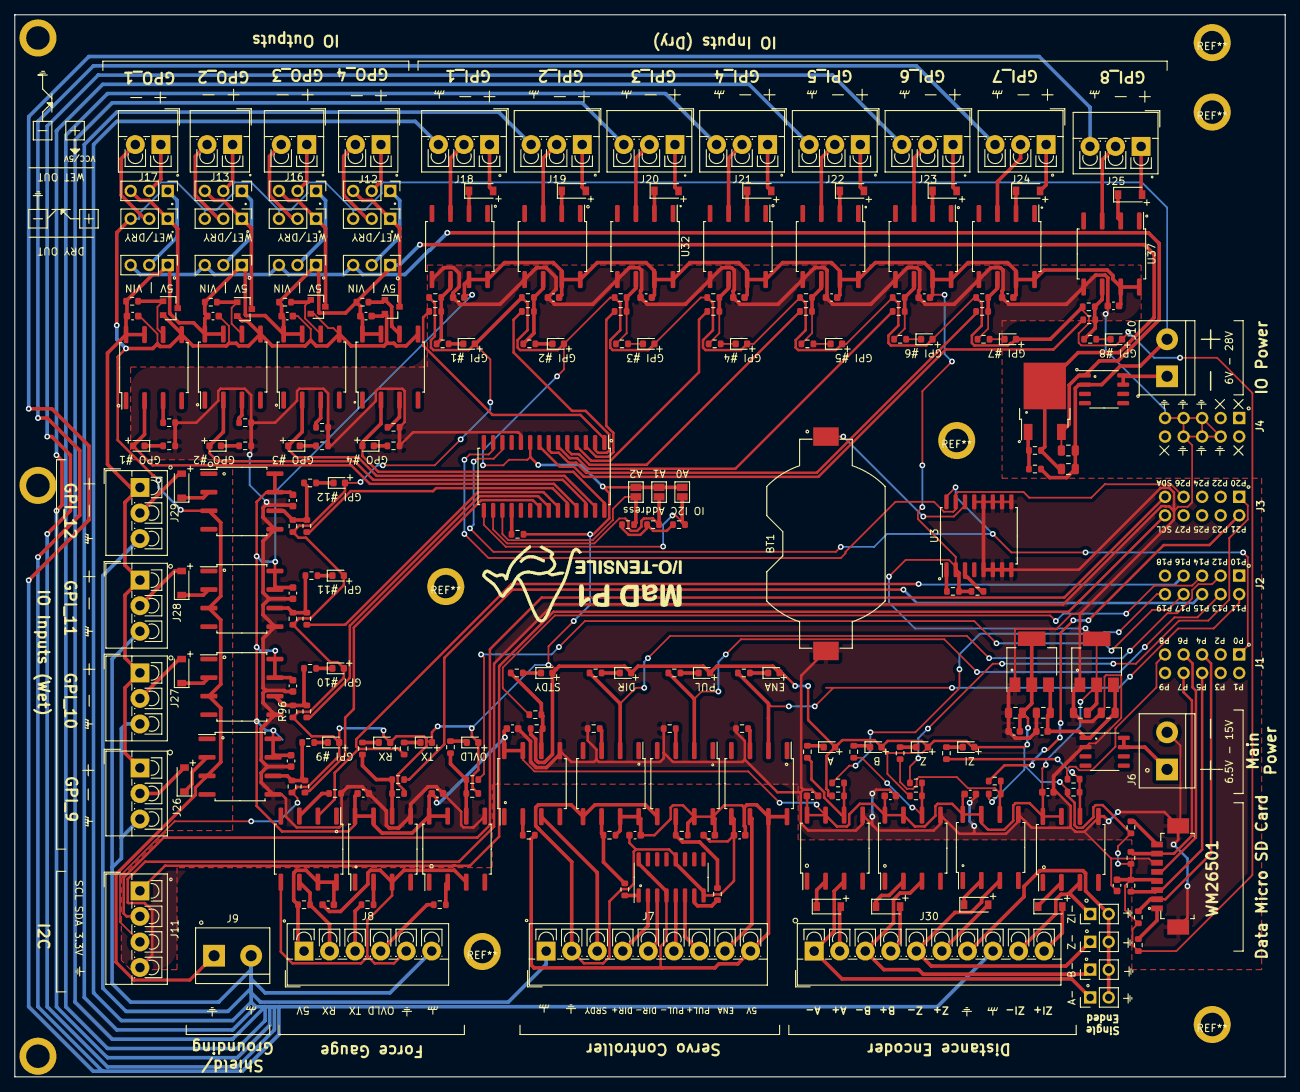
[picture p18: board Tensile_Board.kicad_pcb from above]

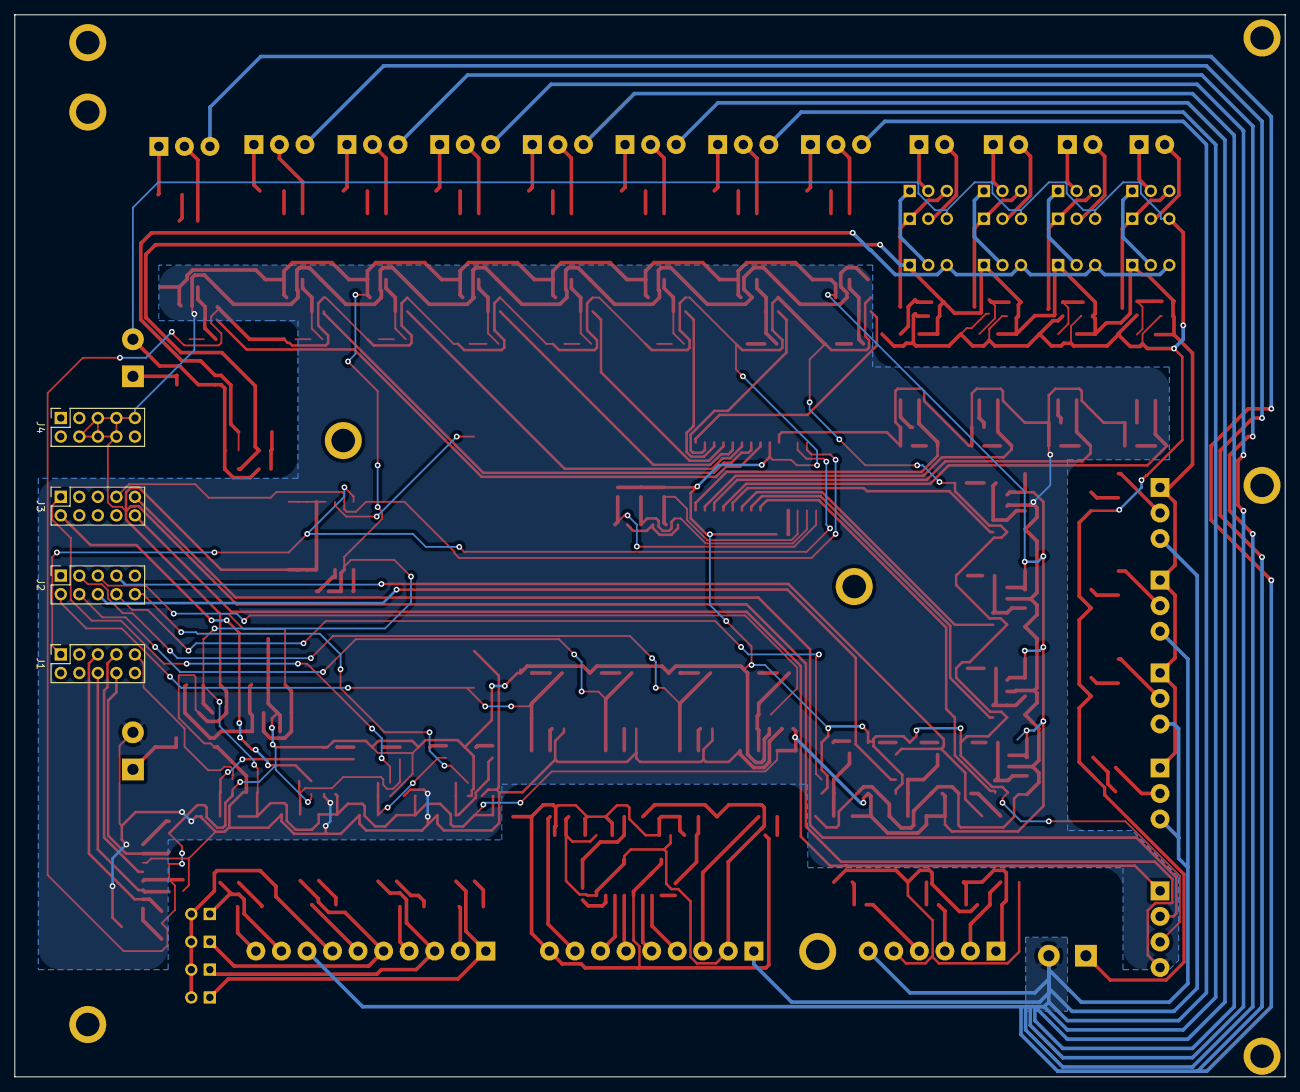
[picture p19: board Tensile_Board.kicad_pcb from below]

Board: 2 copper layers, 174.0 x 145.5 mm, 268 parts (4 on the bottom side), 195 nets.

Other parts of the board:
DISP_HOLE_1, DISP_HOLE_2, DISP_HOLE_3: Hole_5.08
LOGO: LOGO_1
