RileyMcCarthy/IO_Board/(commit log)

2021-02-23 reorganization of files
    [Distance_Gauge.sch, Force_Gauge.sch, IO.xlsx, IO_Expansion.sch, IO_Expansion_2.sch, IO_Expansion_Inputs.sch, Servo_Controller.sch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]
2021-04-02 fixed silk screen issues with rev_1
    [IO_Expansion.sch, Spacer.SLDPRT, Spacer.STEP, Spacer.STL, Tensile_Board.kicad_pcb, Tensile_Board.sch]
